ElectronicCats/badge_hackgdl_2026/Add-ons/Add-on-Pescadito-HackGDL/Footprints/CR2032--3DModel-STEP-56544.STEP

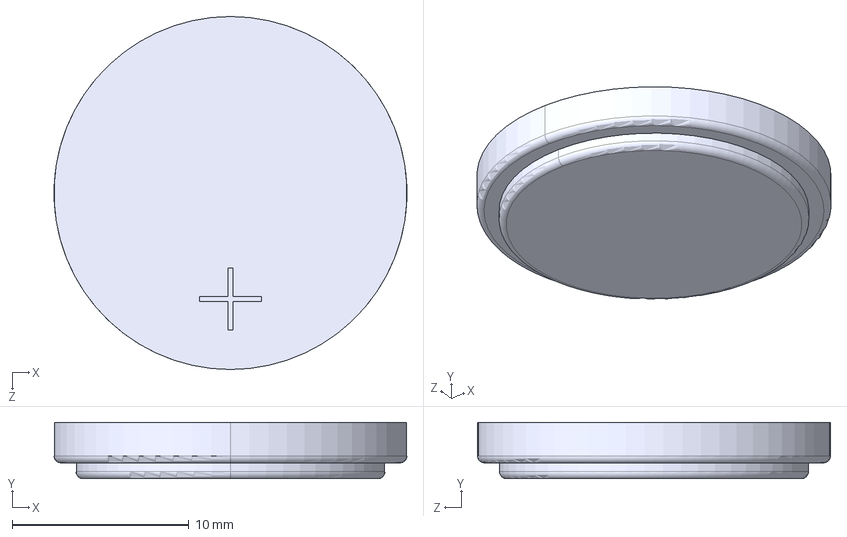
[picture p7: CAD file, 2026-01-30]
Add-ons/Add-on-Pescadito-HackGDL/Footprints/CR2032--3DModel-STEP-56544.STEP
20.0 x 3.20 x 20.0 mm
