ElectronicCats/badge_hackgdl_2026/Add-ons/Add-on-Tortuguita-HackGDL/Footprints/BAT-HLD-001--3DModel-STEP-56544.STEP

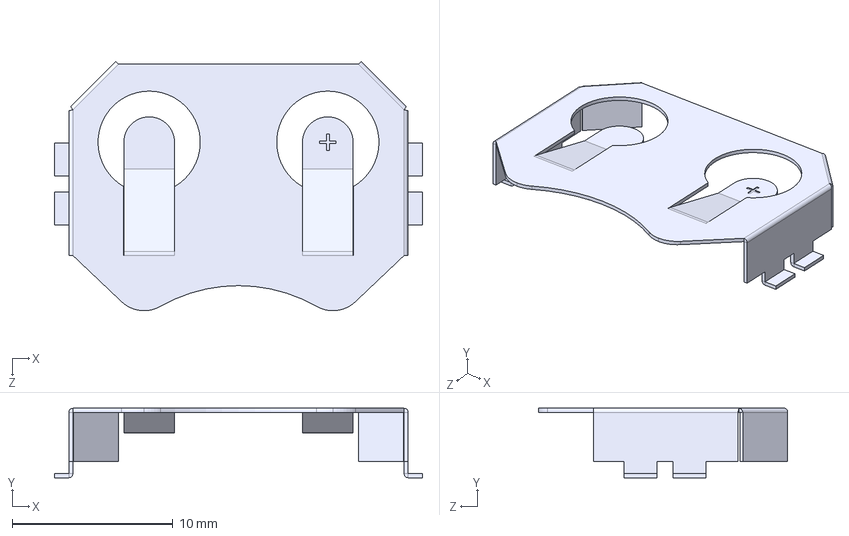
[picture p8: CAD file, 2026-01-30]
Add-ons/Add-on-Tortuguita-HackGDL/Footprints/BAT-HLD-001--3DModel-STEP-56544.STEP
22.9 x 4.32 x 15.5 mm
