ElectronicCats/badge_hackgdl_2026/hardware/Footprints/SON_WSON8_ZE_WIN.step

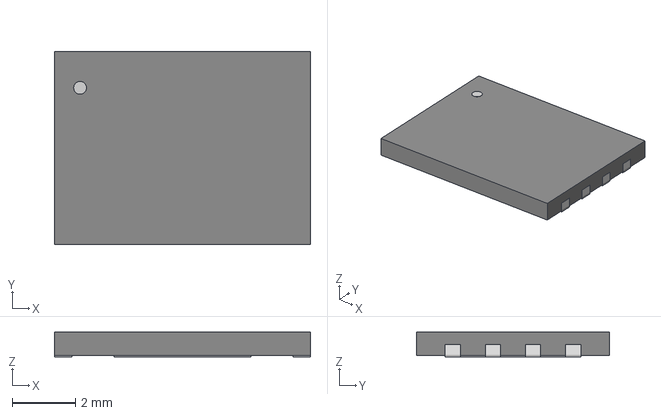
[picture p9: CAD file, 2026-01-27]
hardware/Footprints/SON_WSON8_ZE_WIN.step
8.10 x 6.10 x 0.79 mm
