ElectronicCats/badge_hackgdl_2026/hardware/Rear-Badge-HackGDL-2026/Rear-Badge-HackGDL-2026.step

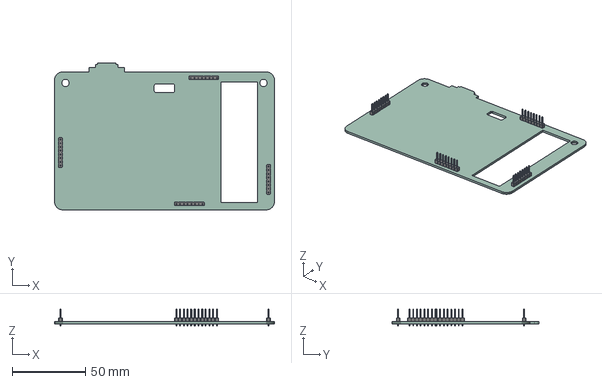
[picture p10: CAD file, 2026-01-27]
hardware/Rear-Badge-HackGDL-2026/Rear-Badge-HackGDL-2026.step
150.0 x 100.0 x 11.5 mm
PinHeader_1x08_P2.54mm_Vertical x 4
Rear-Badge-HackGDL-2026_PCB
