ElectronicCats/badge_hackgdl_2026/Add-ons/Add-on-Pescadito-HackGDL/Footprints/MSK12C02.stp

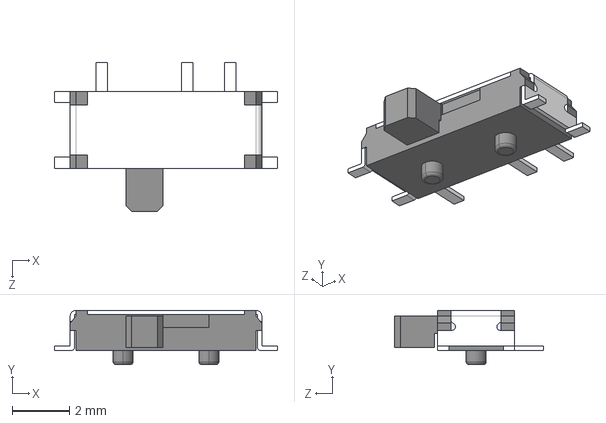
[picture p11: CAD file, 2026-01-30]
Add-ons/Add-on-Pescadito-HackGDL/Footprints/MSK12C02.stp
7.80 x 1.90 x 5.20 mm
