ElectronicCats/badge_hackgdl_2026/Add-ons/Add-on-Tortuguita-HackGDL/Add-on-Tortuguita-HackGDL.kicad_pcb

## KiCad design Add-ons/Add-on-Tortuguita-HackGDL/Add-on-Tortuguita-HackGDL.kicad_pcb (2026-01-30)

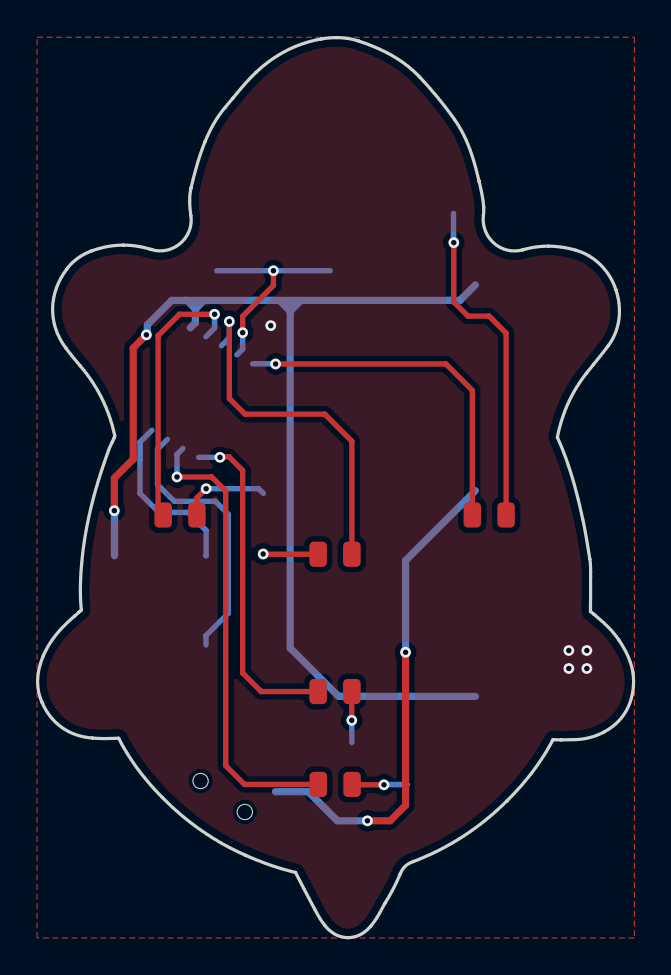
[picture p12: board Add-on-Tortuguita-HackGDL.kicad_pcb from above]

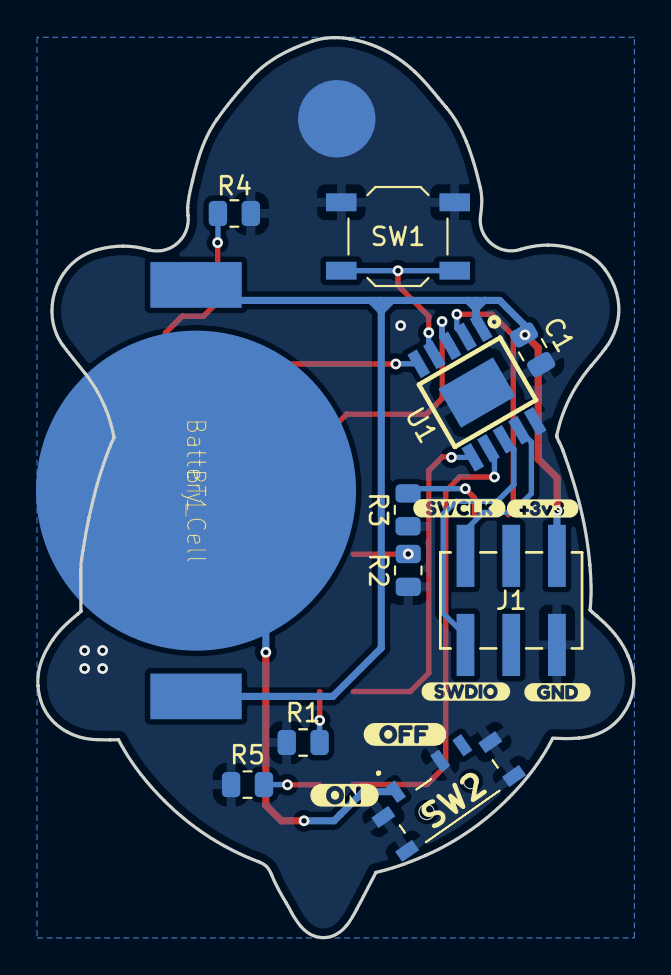
[picture p13: board Add-on-Tortuguita-HackGDL.kicad_pcb from below]

Board: 2 copper layers, 33.1 x 50.0 mm, 22 parts (17 on the bottom side), 16 nets.

Parts:
BT1: Battery_Cell; BAT-HLD-001
C1: 0.1uF; C_0805_2012Metric
D1, D2, D3, D4, D5: Red; LED_0805_2012Metric
J1: Conn_02x03_Odd_Even; B-2100N06P-B111_CKM
R1, R2, R3, R4, R5: 330R; R_0805_2012Metric
SW1: SW_RST; SW_SPST_TL3342
SW2: On; MSK12C02
U1: PY32F002AA15M6TU; PY32F002AA15M
kibuzzard-684B03BD: G***; kibuzzard-684B03BD
kibuzzard-684B03C9: G***; kibuzzard-684B03C9
kibuzzard-697CCF2B: G***; kibuzzard-697CCF2B
kibuzzard-6892952E: G***; kibuzzard-6892952E
kibuzzard-68929515: G***; kibuzzard-68929515
kibuzzard-68929520: G***; kibuzzard-68929520

Connections:
+3.3V: BT1.2 (+), C1.1, J1.6, U1.1 (VCC)
/NRST: SW1.2, U1.4 (PA0/PF2-NRST)
/PA1: D4.2 (A), U1.5 (PA1)
/PA5: D2.2 (A), U1.3 (PA5/PF1-OSCOUT)
/PA6: D1.2 (A), U1.6 (PA6)
/PA7: D5.2 (A), U1.7 (PA7)
/PF0: D3.2 (A), U1.2 (PF0-OSCIN)
/SWCLK: J1.2, U1.9 (PA14-SWC/PB3)
/SWDIO: J1.1, U1.8 (PA13-SWD)
GND: C1.2, J1.5, R1.1, R2.1, R3.1, R4.1, R5.1, SW1.1, SW2.2 (A), SW2.4 (C), U1.10 (GND)
unnamed: BT1.1 (-), SW2.1 (B)
unnamed: D1.1 (K), R1.2
unnamed: D2.1 (K), R2.2
unnamed: D3.1 (K), R3.2
unnamed: D4.1 (K), R4.2
unnamed: D5.1 (K), R5.2
