ElectronicCats/badge_hackgdl_2026/Add-ons/Add-on-Pescadito-HackGDL/Add-on-Pescadito-HackGDL.kicad_pcb

## KiCad design Add-ons/Add-on-Pescadito-HackGDL/Add-on-Pescadito-HackGDL.kicad_pcb (2026-01-30)

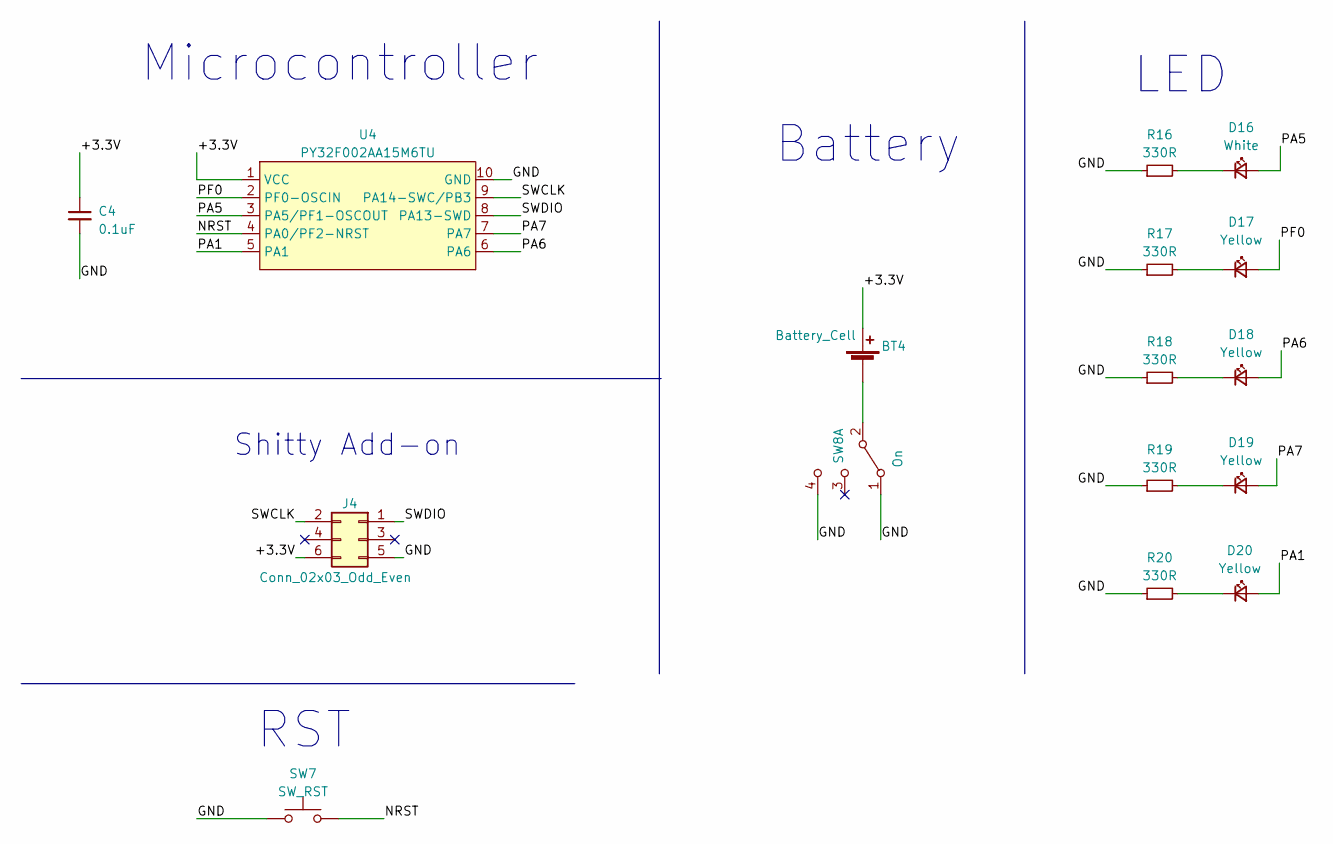
[picture p14: schematic Yellow_Fish.kicad_sch, Add-on_Pescaditos]

Parts:
BT4: Battery_Cell; BAT-HLD-001; LCSC# C964833
C4: 0.1uF; C_0805_2012Metric; LCSC# C235731
D16: White; LED_0805_2012Metric; LCSC# C84258
D17, D18, D19, D20: Yellow; LED_0805_2012Metric; LCSC# C84261
J4: Conn_02x03_Odd_Even; B-2100N06P-B111_CKM; LCSC# C124390
R16, R17, R18, R19, R20: 330R; R_0805_2012Metric; LCSC# C119075
SW7: SW_RST; SW_SPST_TL3342; LCSC# C318889
SW8: On; MSK12C02; LCSC# C431540
U4: PY32F002AA15M6TU; PY32F002AA15M; LCSC# C5292058

Connections:
/Yellow_Fish/+3.3V: BT4.2 (+), C4.1, J4.6, U4.1 (VCC)
/Yellow_Fish/GND: C4.2, J4.5, R16.1, R17.1, R18.1, R19.1, R20.1, SW7.1, SW8.1 (A), SW8.4 (C), U4.10 (GND)
/Yellow_Fish/NRST: SW7.2, U4.4 (PA0/PF2-NRST)
/Yellow_Fish/PA1: D20.2 (A), U4.5 (PA1)
/Yellow_Fish/PA5: D16.2 (A), U4.3 (PA5/PF1-OSCOUT)
/Yellow_Fish/PA6: D18.2 (A), U4.6 (PA6)
/Yellow_Fish/PA7: D19.2 (A), U4.7 (PA7)
/Yellow_Fish/PF0: D17.2 (A), U4.2 (PF0-OSCIN)
/Yellow_Fish/SWCLK: J4.2, U4.9 (PA14-SWC/PB3)
/Yellow_Fish/SWDIO: J4.1, U4.8 (PA13-SWD)
unnamed: BT4.1 (-), SW8.2 (B)
unnamed: D16.1 (K), R16.2
unnamed: D17.1 (K), R17.2
unnamed: D18.1 (K), R18.2
unnamed: D19.1 (K), R19.2
unnamed: D20.1 (K), R20.2

Notes on the sheet:
Battery
LED
Shitty Add-on
Microcontroller
RST

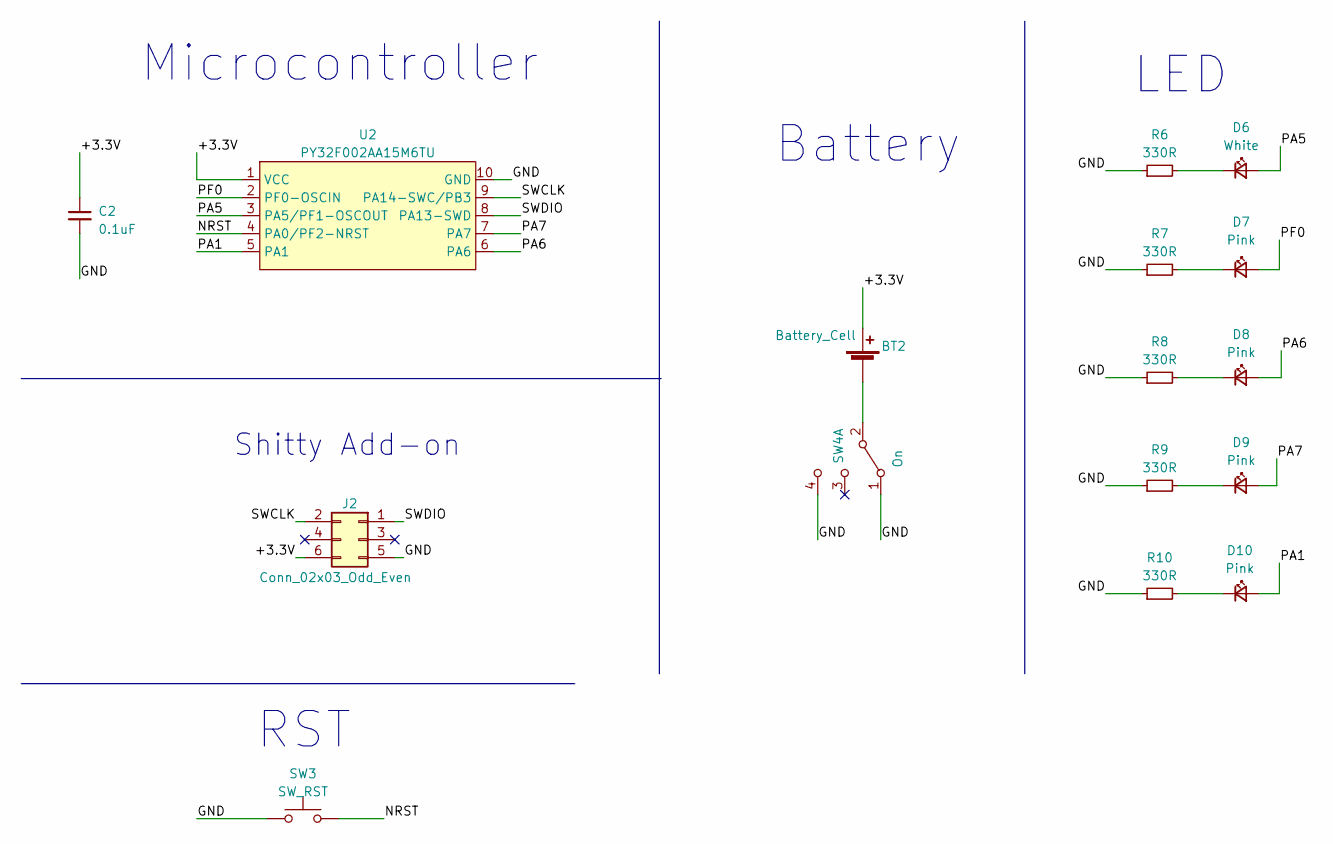
[picture p15: schematic Pink_Fish.kicad_sch, Add-on_Pescaditos]

Parts:
BT2: Battery_Cell; BAT-HLD-001; LCSC# C964833
C2: 0.1uF; C_0805_2012Metric; LCSC# C235731
D6: White; LED_0805_2012Metric; LCSC# C84258
D7, D8, D9, D10: Pink; LED_0805_2012Metric; LCSC# C965821
J2: Conn_02x03_Odd_Even; B-2100N06P-B111_CKM; LCSC# C124390
R6, R7, R8, R9, R10: 330R; R_0805_2012Metric; LCSC# C119075
SW3: SW_RST; SW_SPST_TL3342; LCSC# C318889
SW4: On; MSK12C02; LCSC# C431540
U2: PY32F002AA15M6TU; PY32F002AA15M; LCSC# C5292058

Connections:
/Pink_Fish/+3.3V: BT2.2 (+), C2.1, J2.6, U2.1 (VCC)
/Pink_Fish/GND: C2.2, J2.5, R6.1, R7.1, R8.1, R9.1, R10.1, SW3.1, SW4.1 (A), SW4.4 (C), U2.10 (GND)
/Pink_Fish/NRST: SW3.2, U2.4 (PA0/PF2-NRST)
/Pink_Fish/PA1: D10.2 (A), U2.5 (PA1)
/Pink_Fish/PA5: D6.2 (A), U2.3 (PA5/PF1-OSCOUT)
/Pink_Fish/PA6: D8.2 (A), U2.6 (PA6)
/Pink_Fish/PA7: D9.2 (A), U2.7 (PA7)
/Pink_Fish/PF0: D7.2 (A), U2.2 (PF0-OSCIN)
/Pink_Fish/SWCLK: J2.2, U2.9 (PA14-SWC/PB3)
/Pink_Fish/SWDIO: J2.1, U2.8 (PA13-SWD)
unnamed: BT2.1 (-), SW4.2 (B)
unnamed: D6.1 (K), R6.2
unnamed: D7.1 (K), R7.2
unnamed: D8.1 (K), R8.2
unnamed: D9.1 (K), R9.2
unnamed: D10.1 (K), R10.2

Notes on the sheet:
Microcontroller
LED
RST
Shitty Add-on
Battery

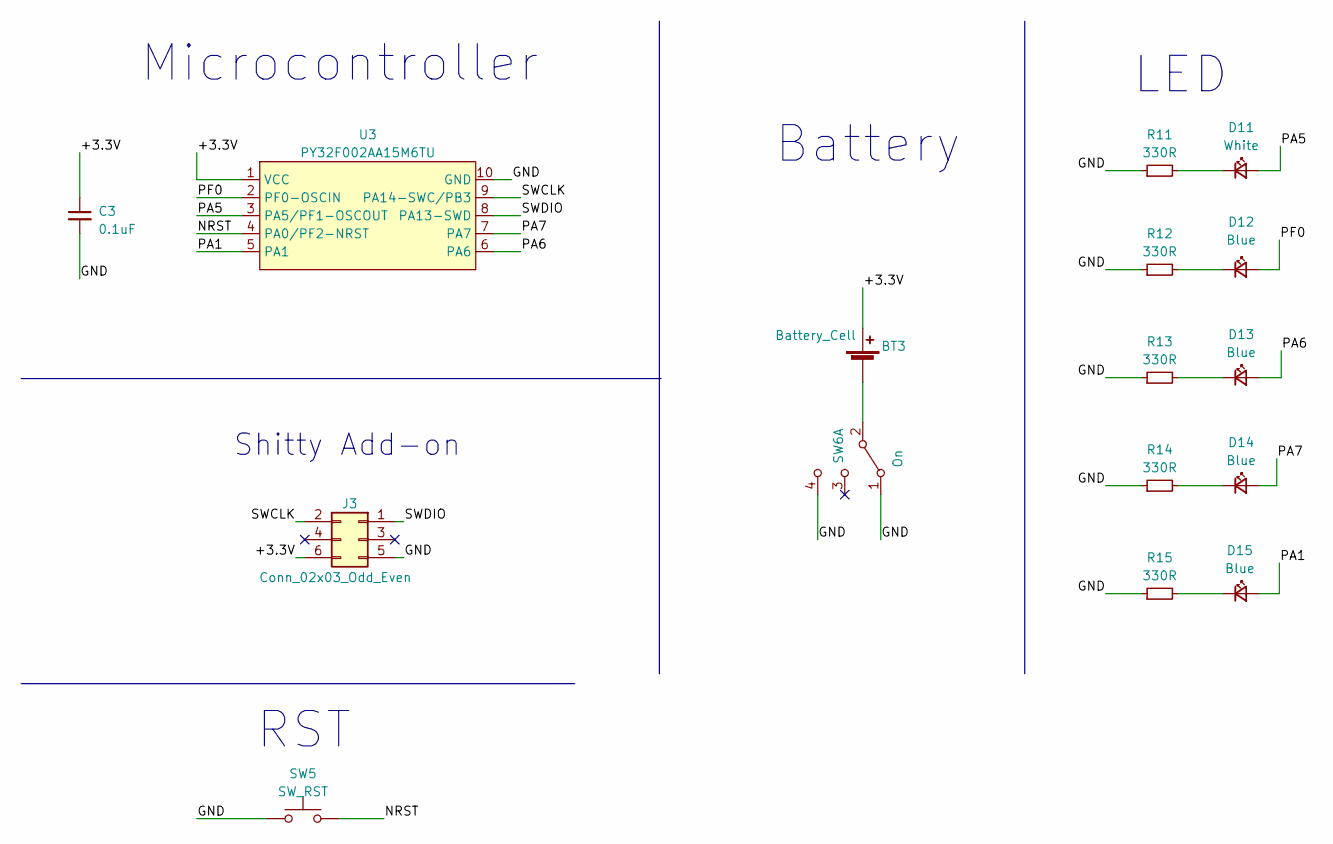
[picture p16: schematic Blue_Fish.kicad_sch, Add-on_Pescaditos]

Parts:
BT3: Battery_Cell; BAT-HLD-001; LCSC# C964833
C3: 0.1uF; C_0805_2012Metric; LCSC# C235731
D11: White; LED_0805_2012Metric; LCSC# C84258
D12, D13, D14, D15: Blue; LED_0805_2012Metric; LCSC# C205441
J3: Conn_02x03_Odd_Even; B-2100N06P-B111_CKM; LCSC# C124390
R11, R12, R13, R14, R15: 330R; R_0805_2012Metric; LCSC# C119075
SW5: SW_RST; SW_SPST_TL3342; LCSC# C318889
SW6: On; MSK12C02; LCSC# C431540
U3: PY32F002AA15M6TU; PY32F002AA15M; LCSC# C5292058

Connections:
/Blue_Fish/+3.3V: BT3.2 (+), C3.1, J3.6, U3.1 (VCC)
/Blue_Fish/GND: C3.2, J3.5, R11.1, R12.1, R13.1, R14.1, R15.1, SW5.1, SW6.1 (A), SW6.4 (C), U3.10 (GND)
/Blue_Fish/NRST: SW5.2, U3.4 (PA0/PF2-NRST)
/Blue_Fish/PA1: D15.2 (A), U3.5 (PA1)
/Blue_Fish/PA5: D11.2 (A), U3.3 (PA5/PF1-OSCOUT)
/Blue_Fish/PA6: D13.2 (A), U3.6 (PA6)
/Blue_Fish/PA7: D14.2 (A), U3.7 (PA7)
/Blue_Fish/PF0: D12.2 (A), U3.2 (PF0-OSCIN)
/Blue_Fish/SWCLK: J3.2, U3.9 (PA14-SWC/PB3)
/Blue_Fish/SWDIO: J3.1, U3.8 (PA13-SWD)
unnamed: BT3.1 (-), SW6.2 (B)
unnamed: D11.1 (K), R11.2
unnamed: D12.1 (K), R12.2
unnamed: D13.1 (K), R13.2
unnamed: D14.1 (K), R14.2
unnamed: D15.1 (K), R15.2

Notes on the sheet:
Shitty Add-on
Battery
RST
LED
Microcontroller

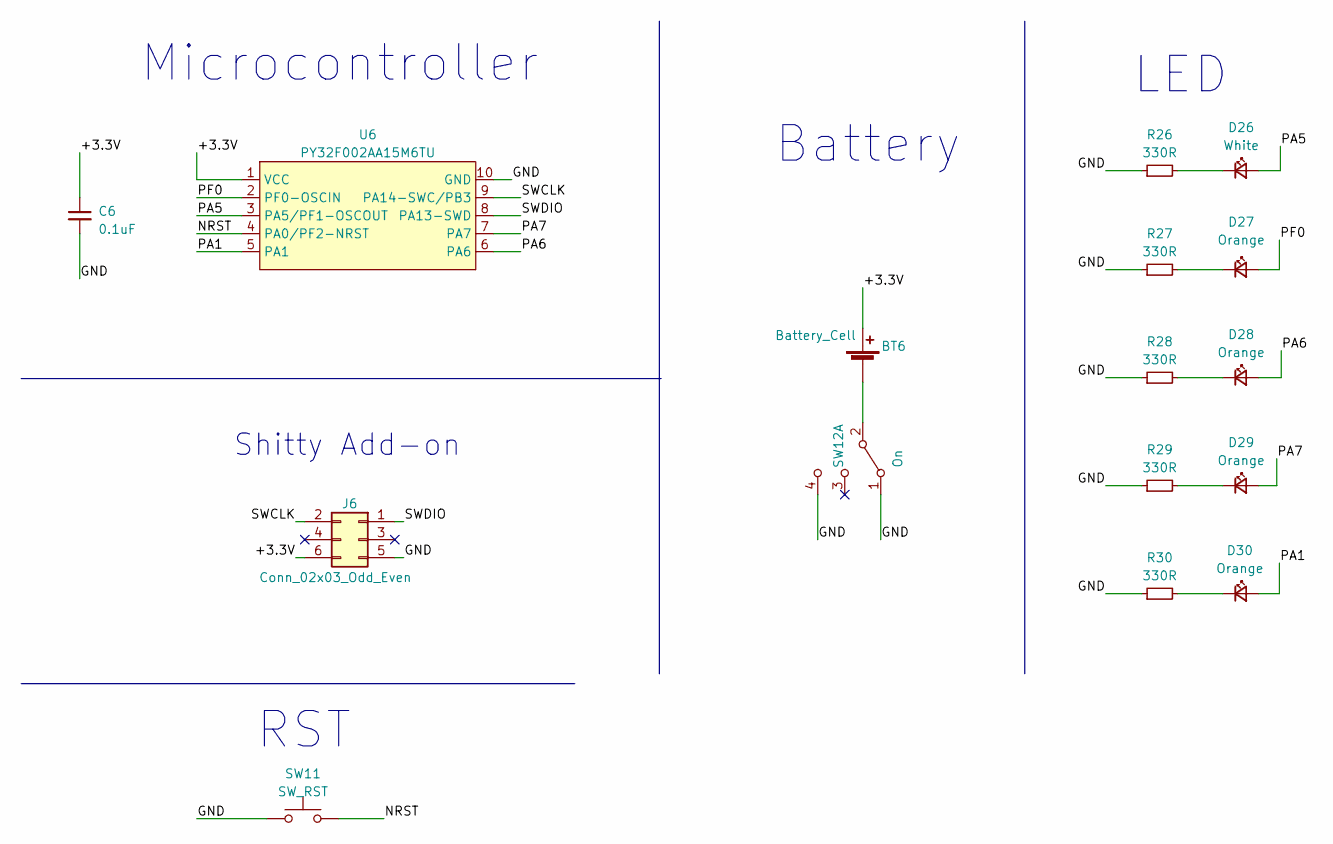
[picture p17: schematic Orange_Fish.kicad_sch, Add-on_Pescaditos]

Parts:
BT6: Battery_Cell; BAT-HLD-001; LCSC# C964833
C6: 0.1uF; C_0805_2012Metric; LCSC# C235731
D26: White; LED_0805_2012Metric; LCSC# C84258
D27, D28, D29, D30: Orange; LED_0805_2012Metric; LCSC# C434437
J6: Conn_02x03_Odd_Even; B-2100N06P-B111_CKM; LCSC# C124390
R26, R27, R28, R29, R30: 330R; R_0805_2012Metric; LCSC# C119075
SW11: SW_RST; SW_SPST_TL3342; LCSC# C318889
SW12: On; MSK12C02; LCSC# C431540
U6: PY32F002AA15M6TU; PY32F002AA15M; LCSC# C5292058

Connections:
/Orange_Fish/+3.3V: BT6.2 (+), C6.1, J6.6, U6.1 (VCC)
/Orange_Fish/GND: C6.2, J6.5, R26.1, R27.1, R28.1, R29.1, R30.1, SW11.1, SW12.1 (A), SW12.4 (C), U6.10 (GND)
/Orange_Fish/NRST: SW11.2, U6.4 (PA0/PF2-NRST)
/Orange_Fish/PA1: D30.2 (A), U6.5 (PA1)
/Orange_Fish/PA5: D26.2 (A), U6.3 (PA5/PF1-OSCOUT)
/Orange_Fish/PA6: D28.2 (A), U6.6 (PA6)
/Orange_Fish/PA7: D29.2 (A), U6.7 (PA7)
/Orange_Fish/PF0: D27.2 (A), U6.2 (PF0-OSCIN)
/Orange_Fish/SWCLK: J6.2, U6.9 (PA14-SWC/PB3)
/Orange_Fish/SWDIO: J6.1, U6.8 (PA13-SWD)
unnamed: BT6.1 (-), SW12.2 (B)
unnamed: D26.1 (K), R26.2
unnamed: D27.1 (K), R27.2
unnamed: D28.1 (K), R28.2
unnamed: D29.1 (K), R29.2
unnamed: D30.1 (K), R30.2

Notes on the sheet:
LED
Shitty Add-on
Battery
Microcontroller
RST

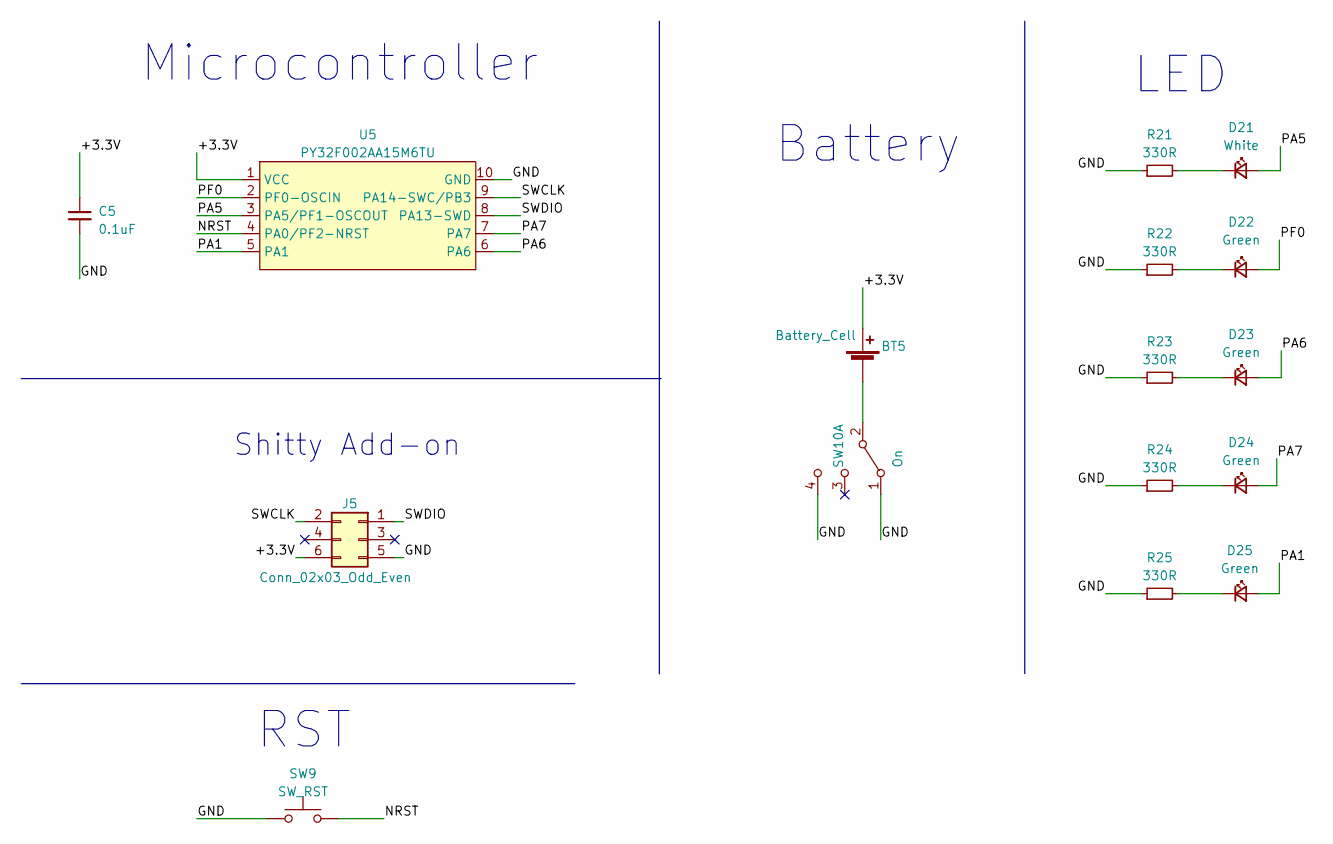
[picture p18: schematic Green_Fish.kicad_sch, Add-on_Pescaditos]

Parts:
BT5: Battery_Cell; BAT-HLD-001; LCSC# C964833
C5: 0.1uF; C_0805_2012Metric; LCSC# C235731
D21: White; LED_0805_2012Metric; LCSC# C84258
D22, D23, D24, D25: Green; LED_0805_2012Metric; LCSC# C965815
J5: Conn_02x03_Odd_Even; B-2100N06P-B111_CKM; LCSC# C124390
R21, R22, R23, R24, R25: 330R; R_0805_2012Metric; LCSC# C119075
SW9: SW_RST; SW_SPST_TL3342; LCSC# C318889
SW10: On; MSK12C02; LCSC# C431540
U5: PY32F002AA15M6TU; PY32F002AA15M; LCSC# C5292058

Connections:
/Green_Fish/+3.3V: BT5.2 (+), C5.1, J5.6, U5.1 (VCC)
/Green_Fish/GND: C5.2, J5.5, R21.1, R22.1, R23.1, R24.1, R25.1, SW9.1, SW10.1 (A), SW10.4 (C), U5.10 (GND)
/Green_Fish/NRST: SW9.2, U5.4 (PA0/PF2-NRST)
/Green_Fish/PA1: D25.2 (A), U5.5 (PA1)
/Green_Fish/PA5: D21.2 (A), U5.3 (PA5/PF1-OSCOUT)
/Green_Fish/PA6: D23.2 (A), U5.6 (PA6)
/Green_Fish/PA7: D24.2 (A), U5.7 (PA7)
/Green_Fish/PF0: D22.2 (A), U5.2 (PF0-OSCIN)
/Green_Fish/SWCLK: J5.2, U5.9 (PA14-SWC/PB3)
/Green_Fish/SWDIO: J5.1, U5.8 (PA13-SWD)
unnamed: BT5.1 (-), SW10.2 (B)
unnamed: D21.1 (K), R21.2
unnamed: D22.1 (K), R22.2
unnamed: D23.1 (K), R23.2
unnamed: D24.1 (K), R24.2
unnamed: D25.1 (K), R25.2

Notes on the sheet:
Battery
RST
Shitty Add-on
Microcontroller
LED

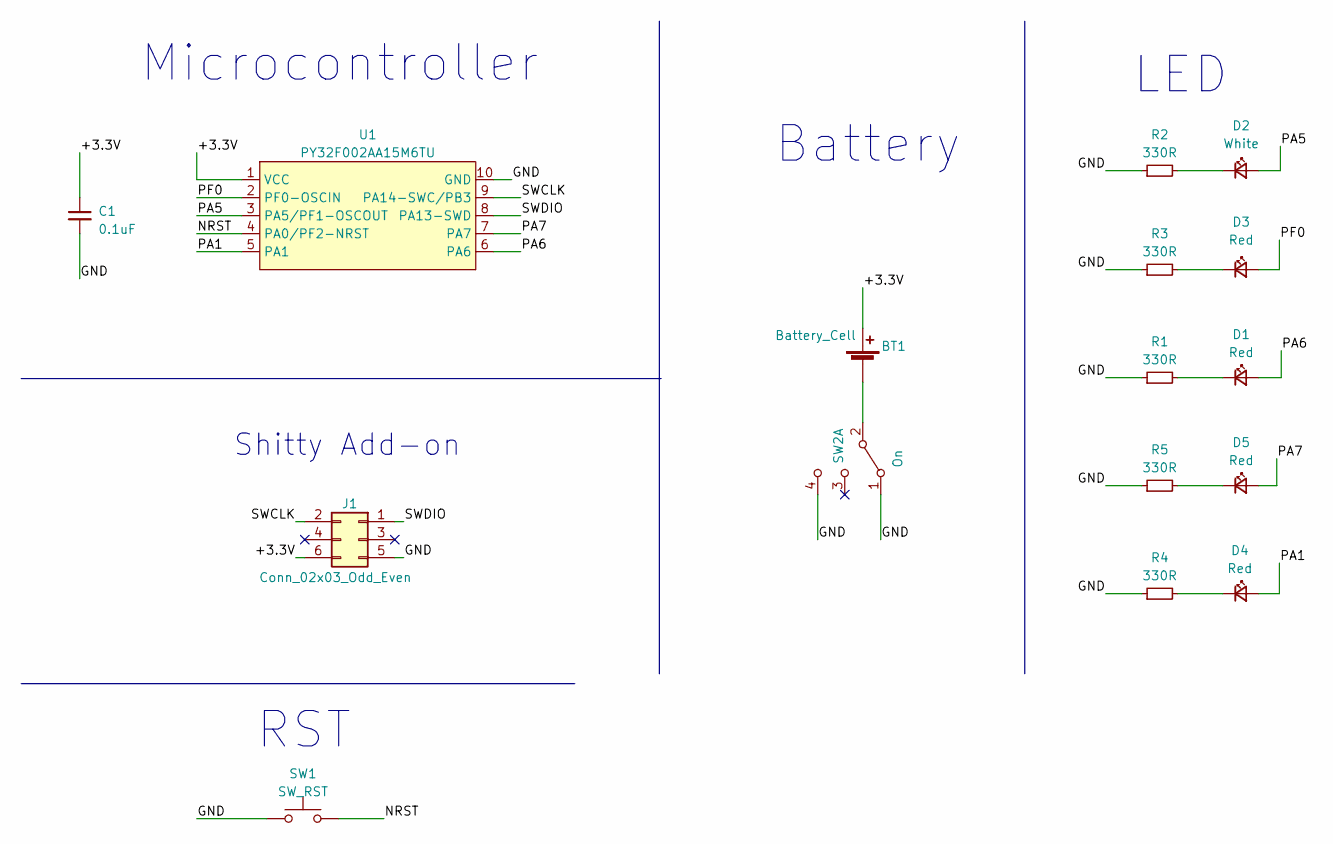
[picture p19: schematic Red_Fish.kicad_sch, Add-on_Pescaditos]

Parts:
BT1: Battery_Cell; BAT-HLD-001; LCSC# C964833
C1: 0.1uF; C_0805_2012Metric; LCSC# C235731
D1, D3, D4, D5: Red; LED_0805_2012Metric; LCSC# C965812
D2: White; LED_0805_2012Metric; LCSC# C84258
J1: Conn_02x03_Odd_Even; B-2100N06P-B111_CKM; LCSC# C124390
R1, R2, R3, R4, R5: 330R; R_0805_2012Metric; LCSC# C119075
SW1: SW_RST; SW_SPST_TL3342; LCSC# C318889
SW2: On; MSK12C02; LCSC# C431540
U1: PY32F002AA15M6TU; PY32F002AA15M; LCSC# C5292058

Connections:
/Red_Fish/+3.3V: BT1.2 (+), C1.1, J1.6, U1.1 (VCC)
/Red_Fish/GND: C1.2, J1.5, R1.1, R2.1, R3.1, R4.1, R5.1, SW1.1, SW2.1 (A), SW2.4 (C), U1.10 (GND)
/Red_Fish/NRST: SW1.2, U1.4 (PA0/PF2-NRST)
/Red_Fish/PA1: D4.2 (A), U1.5 (PA1)
/Red_Fish/PA5: D2.2 (A), U1.3 (PA5/PF1-OSCOUT)
/Red_Fish/PA6: D1.2 (A), U1.6 (PA6)
/Red_Fish/PA7: D5.2 (A), U1.7 (PA7)
/Red_Fish/PF0: D3.2 (A), U1.2 (PF0-OSCIN)
/Red_Fish/SWCLK: J1.2, U1.9 (PA14-SWC/PB3)
/Red_Fish/SWDIO: J1.1, U1.8 (PA13-SWD)
unnamed: BT1.1 (-), SW2.2 (B)
unnamed: D1.1 (K), R1.2
unnamed: D2.1 (K), R2.2
unnamed: D3.1 (K), R3.2
unnamed: D4.1 (K), R4.2
unnamed: D5.1 (K), R5.2

Notes on the sheet:
LED
Battery
Microcontroller
RST
Shitty Add-on

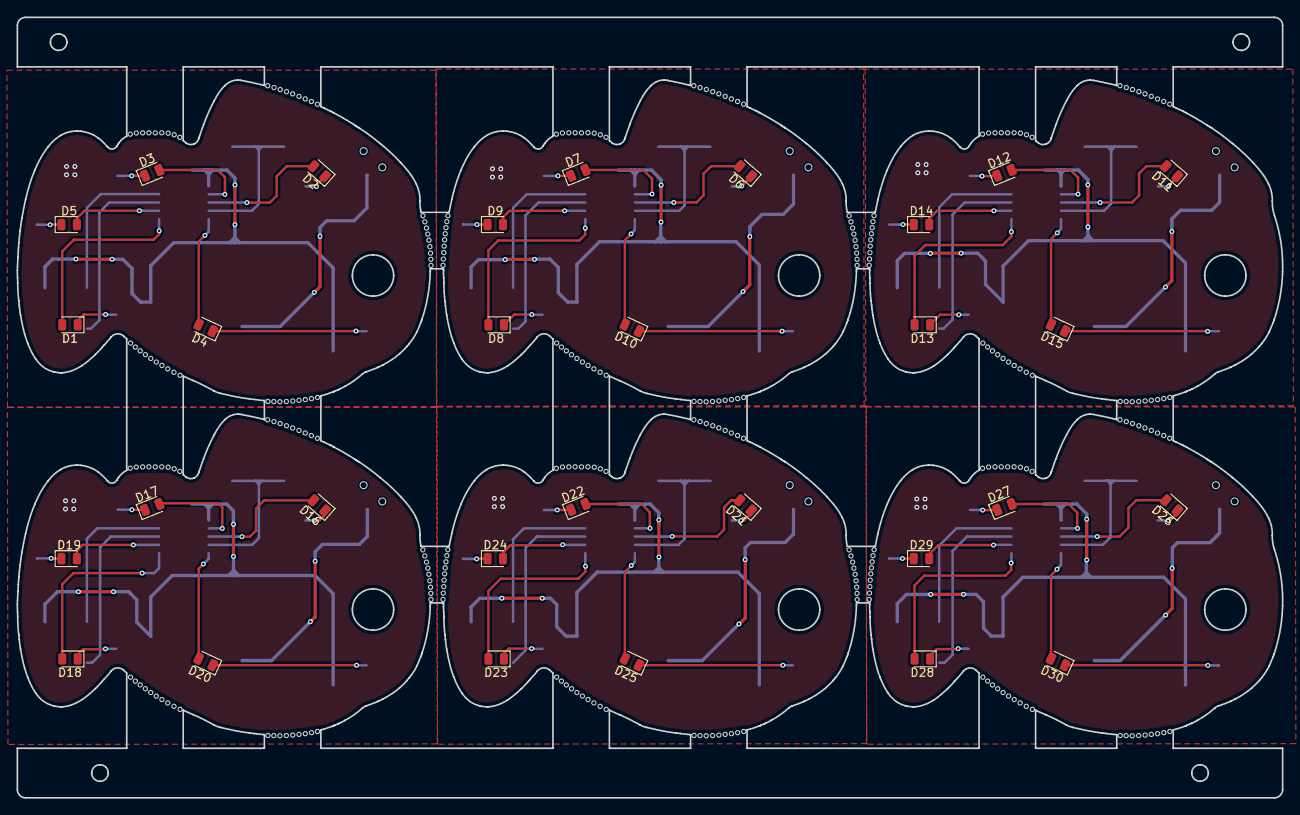
[picture p20: board Add-on-Pescadito-HackGDL.kicad_pcb from above]

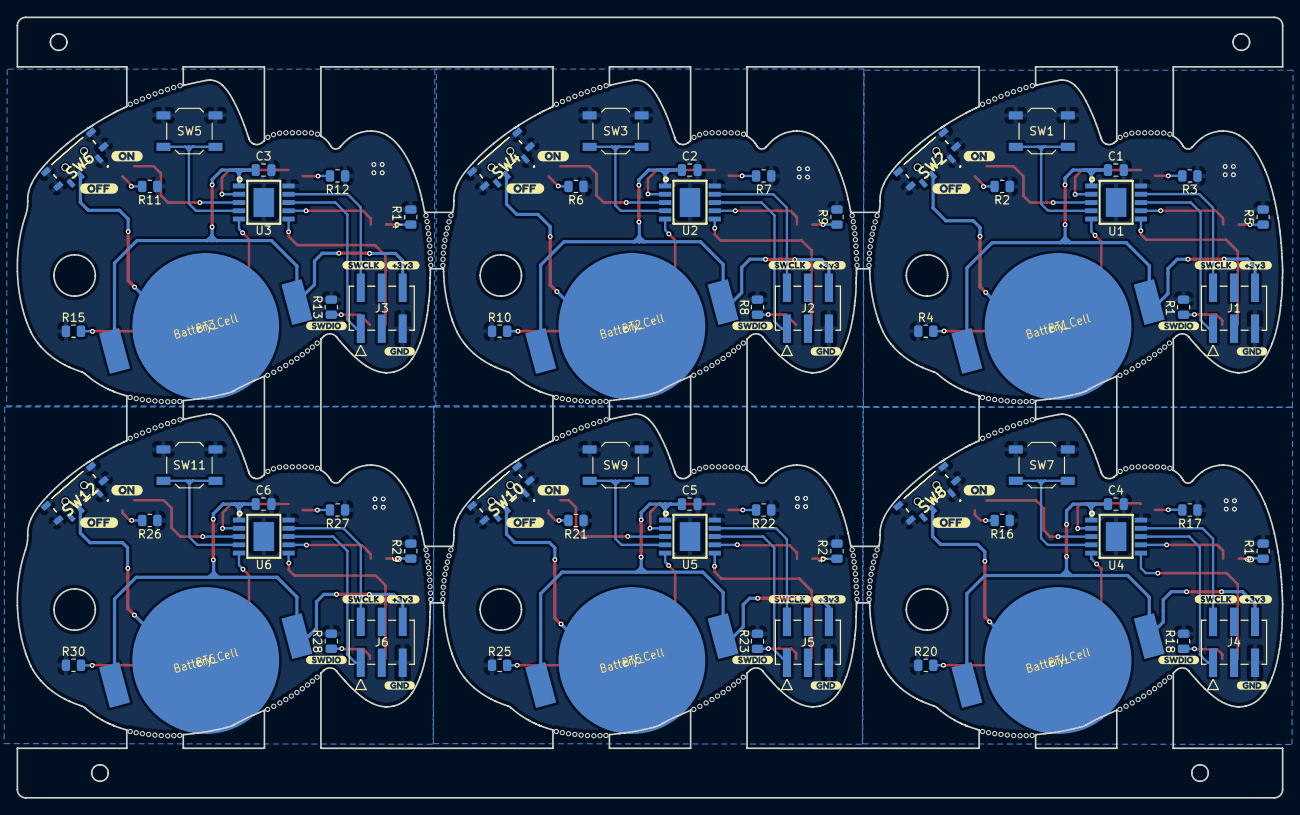
[picture p21: board Add-on-Pescadito-HackGDL.kicad_pcb from below]

Board: 2 copper layers, 153.2 x 94.5 mm, 132 parts (102 on the bottom side), 96 nets.

Other parts of the board:
kibuzzard-684B03BD, kibuzzard-684B03BD#2, kibuzzard-684B03BD#3, kibuzzard-684B03BD#4, kibuzzard-684B03BD#5, kibuzzard-684B03BD#6: G***; kibuzzard-684B03BD
kibuzzard-684B03C9, kibuzzard-684B03C9#2, kibuzzard-684B03C9#3, kibuzzard-684B03C9#4, kibuzzard-684B03C9#5, kibuzzard-684B03C9#6: G***; kibuzzard-684B03C9
kibuzzard-697CCF2B, kibuzzard-697CCF2B#2, kibuzzard-697CCF2B#3, kibuzzard-697CCF2B#4, kibuzzard-697CCF2B#5, kibuzzard-697CCF2B#6: G***; kibuzzard-697CCF2B
kibuzzard-6892952E, kibuzzard-6892952E#2, kibuzzard-6892952E#3, kibuzzard-6892952E#4, kibuzzard-6892952E#5, kibuzzard-6892952E#6: G***; kibuzzard-6892952E
kibuzzard-68929515, kibuzzard-68929515#2, kibuzzard-68929515#3, kibuzzard-68929515#4, kibuzzard-68929515#5, kibuzzard-68929515#6: G***; kibuzzard-68929515
kibuzzard-68929520, kibuzzard-68929520#2, kibuzzard-68929520#3, kibuzzard-68929520#4, kibuzzard-68929520#5, kibuzzard-68929520#6: G***; kibuzzard-68929520
