ElectronicCats/badge_hackgdl_2026/hardware/Badge-HackGDL-2026.kicad_pcb

## KiCad design hardware/Badge-HackGDL-2026.kicad_pcb (2026-01-27)

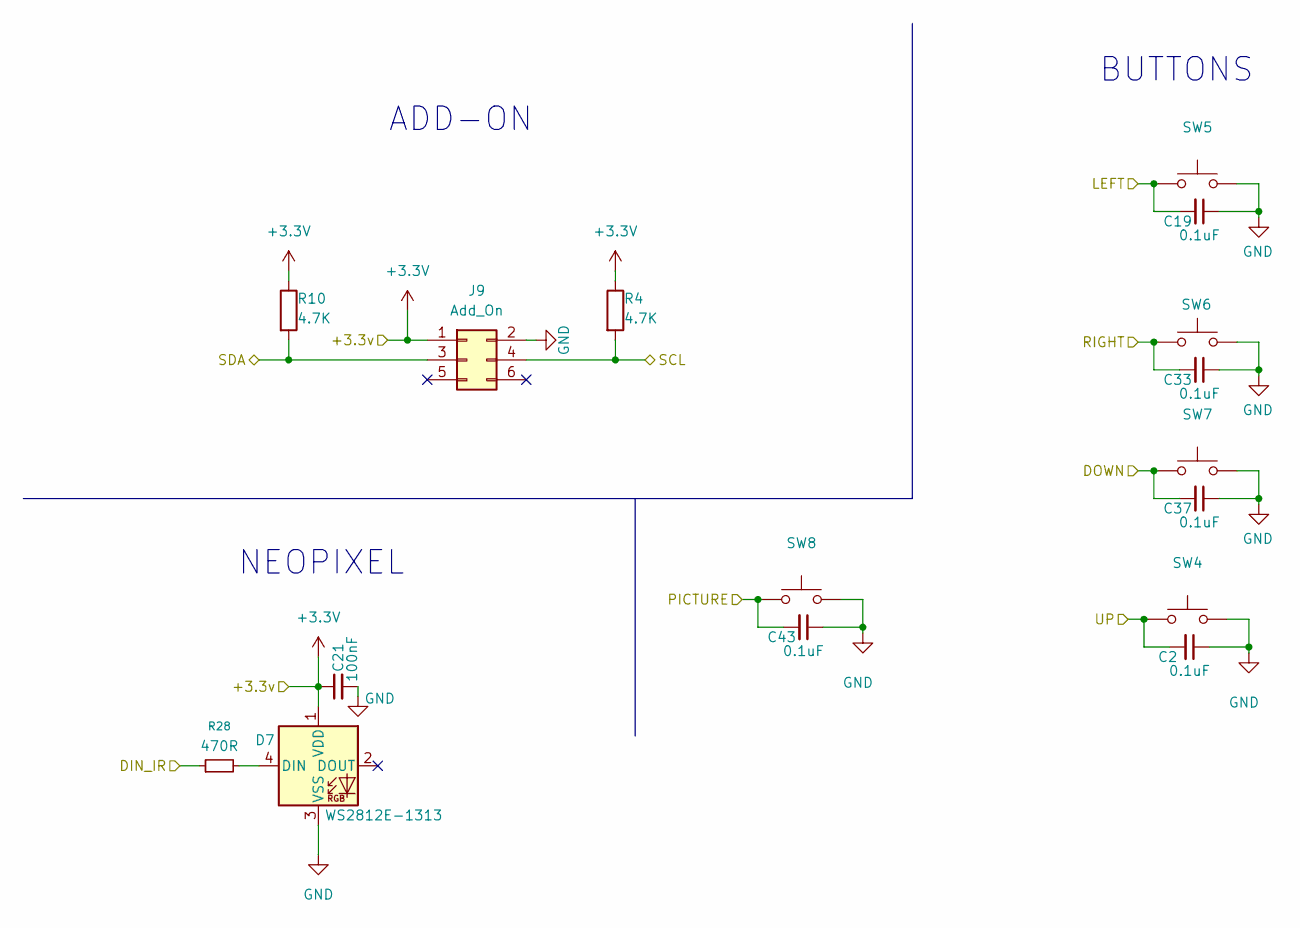
[picture p22: schematic Otros.kicad_sch, Badge-HackGDL-2026]

Parts:
C2, C19, C33, C37, C43: 0.1uF; C_0603_1608Metric; LCSC# C478888
C21: 100nF; C_0402_1005Metric; LCSC# C77020
D7: WS2812E-1313; LCSC# C5446700
J9: Add_On; PinSocket_2x03_P2.54mm_Vertical; LCSC# C5116527
R4, R10: 4.7K; C_0603_1608Metric; LCSC# C2907166
R28: 470R; R_0603_1608Metric; LCSC# C23179
SW4, SW5, SW6, SW7: SW_SPST_TL3342; LCSC# C318889
SW8: Button_6.6x6.5; LCSC# C480263

Connections:
+3.3V: C21.1, D7.1 (VDD), J9.1, R4.1, R10.1; also elsewhere on the board
/MCU/DIN_IR: R28.1; also elsewhere on the board
/MCU/DOWN: C37.2, SW7.2; also elsewhere on the board
/MCU/LEFT: C19.2, SW5.2; also elsewhere on the board
/MCU/PICTURE: C43.2, SW8.2; also elsewhere on the board
/MCU/RIGHT: C33.2, SW6.2; also elsewhere on the board
/MCU/SCL: J9.4, R4.2; also elsewhere on the board
/MCU/SDA: J9.3, R10.2; also elsewhere on the board
/MCU/UP: C2.2, SW4.2; also elsewhere on the board
GND: C2.1, C19.1, C21.2, C33.1, C37.1, C43.1, D7.3 (VSS), J9.2, SW4.1, SW5.1, SW6.1, SW7.1, SW8.1; also elsewhere on the board
unnamed: D7.4 (DIN), R28.2

Notes on the sheet:
BUTTONS
ADD-ON
NEOPIXEL

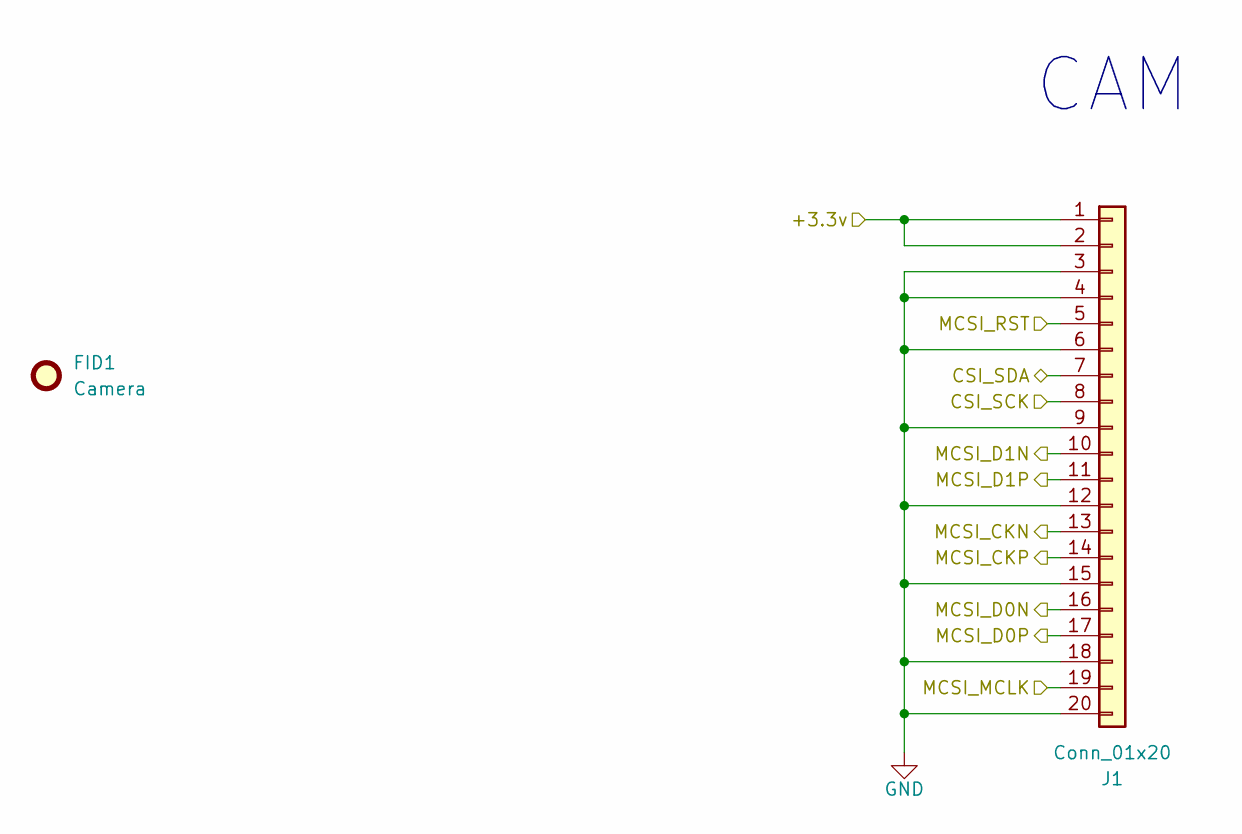
[picture p23: schematic Cam.kicad_sch, Badge-HackGDL-2026]

Parts:
FID1: Camera; Untitled
J1: Conn_01x20; Hirose_FH12-20S-0.5SH_1x20-1MP_P0.50mm_Horizontal; LCSC# C2906119

Connections:
+3.3V: J1.1, J1.2; also elsewhere on the board
/Cam/CSI_SCK: J1.8; also elsewhere on the board
/Cam/CSI_SDA: J1.7; also elsewhere on the board
/Cam/MCSI_CKN: J1.13; also elsewhere on the board
/Cam/MCSI_CKP: J1.14; also elsewhere on the board
/Cam/MCSI_D0N: J1.16; also elsewhere on the board
/Cam/MCSI_D0P: J1.17; also elsewhere on the board
/Cam/MCSI_D1N: J1.10; also elsewhere on the board
/Cam/MCSI_D1P: J1.11; also elsewhere on the board
/Cam/MCSI_MCLK: J1.19; also elsewhere on the board
/Cam/MCSI_RST: J1.5; also elsewhere on the board
GND: J1.3, J1.4, J1.6, J1.9, J1.12, J1.15, J1.18, J1.20; also elsewhere on the board

Notes on the sheet:
CAM
