ElectronicCats/badge_hackgdl_2026/hardware/Badge-HackGDL-2026.kicad_pcb

## KiCad design hardware/Badge-HackGDL-2026.kicad_pcb (continued)

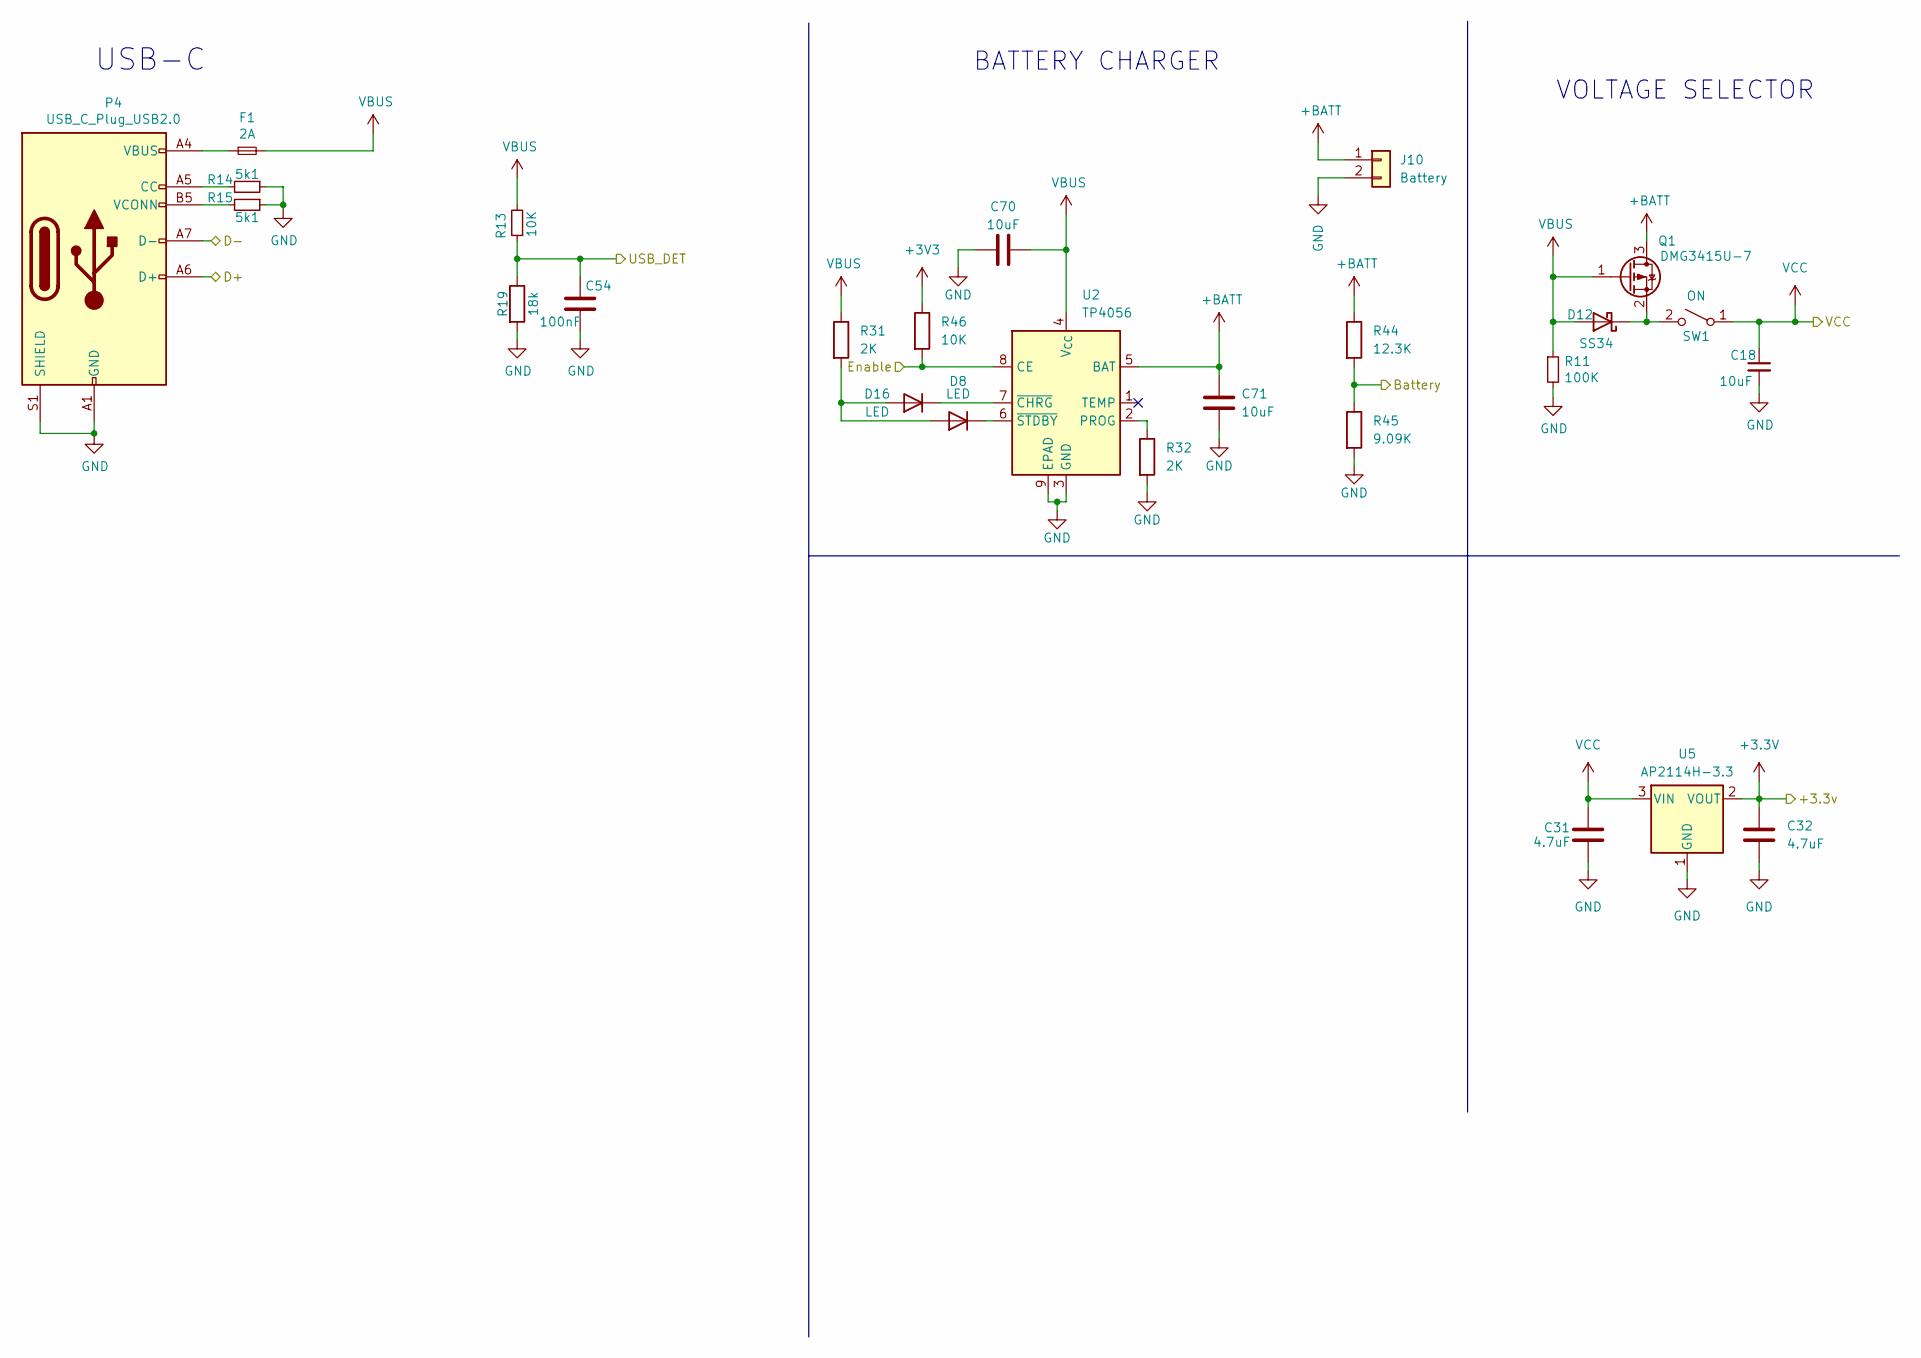
[picture p24: schematic USB.kicad_sch, Badge-HackGDL-2026]

Parts:
C18: 10uF; C_0402_1005Metric; LCSC# C7472949
C31, C32: 4.7uF; C_0402_1005Metric; LCSC# C368809
C54: 100nF; C_0402_1005Metric; LCSC# C77020
C70, C71: 10uF; C_0603_1608Metric; LCSC# C96446
D8, D16: LED; LED_0603_1608Metric; LCSC# C22371297
D12: SS34; D_SMA; LCSC# C908680
F1: 2A; Fuse_0603_1608Metric; LCSC# C41380229
J10: Battery; BatteryHolder_Keystone_1042_1x18650; LCSC# C2988620
P4: USB_C_Plug_USB2.0; C393939; LCSC# C2760486
Q1: DMG3415U-7; SOT-23; LCSC# C96616
R11: 100K; R_0603_1608Metric; LCSC# C15458
R13, R46: 10K; R_0402_1005Metric; LCSC# C2759535
R14, R15: 5k1; R_0603_1608Metric; LCSC# C2907044
R19: 18k; R_0402_1005Metric; LCSC# C323741
R31, R32: 2K; R_0603_1608Metric; LCSC# C2907022
R44: 12.3K; R_0402_1005Metric; LCSC# C346621
R45: 9.09K; R_0402_1005Metric; LCSC# C852966
SW1: ON; SW_Slide_SPDT_Angled_CK_OS102011MA1Q; LCSC# C393937
U2: TP4056; SOIC-8-1EP_3.9x4.9mm_P1.27mm_EP2.41x3.3mm_ThermalVias; LCSC# C725790
U5: AP2114H-3.3; SOT-223-3_TabPin2; LCSC# C150716

Connections:
+3.3V: C32.1, U5.2 (VOUT); also elsewhere on the board
+3V3: R46.1; also elsewhere on the board
+BATT: C71.1, J10.1, Q1.3 (D), R44.1, U2.5 (BAT)
/MCU/Battery: R44.2, R45.1; also elsewhere on the board
/MCU/D+: P4.A6 (D+); also elsewhere on the board
/MCU/D-: P4.A7 (D-); also elsewhere on the board
/MCU/Enable: R46.2, U2.8 (CE); also elsewhere on the board
/MCU/USB_DET: C54.1, R13.1, R19.1; also elsewhere on the board
GND: C18.2, C31.2, C32.2, C54.2, C70.1, C71.2, J10.2, P4.A1 (GND), P4.A12 (GND), P4.B1 (GND), P4.B12 (GND), P4.S1 (SHIELD), R11.2, R14.1, R15.1, R19.2, R32.2, R45.2, U2.3 (GND), U2.9 (EPAD), U5.1 (GND); also elsewhere on the board
unnamed: D8.1 (K), U2.6 (~STDBY)
unnamed: D12.1 (K), Q1.2 (S), SW1.2 (B)
unnamed: D8.2 (A), D16.2 (A), R31.2
unnamed: D16.1 (K), U2.7 (~CHRG)
unnamed: F1.1, P4.A4 (VBUS), P4.A9 (VBUS), P4.B4 (VBUS), P4.B9 (VBUS)
unnamed: P4.A5 (CC), R14.2
unnamed: P4.B5 (VCONN), R15.2
unnamed: R32.1, U2.2 (PROG)
VBUS: C70.2, D12.2 (A), F1.2, Q1.1 (G), R11.1, R13.2, R31.1, U2.4 (V_{CC})
VCC: C18.1, C31.1, SW1.1 (A), U5.3 (VIN); also elsewhere on the board

Notes on the sheet:
VOLTAGE SELECTOR
USB-C
BATTERY CHARGER

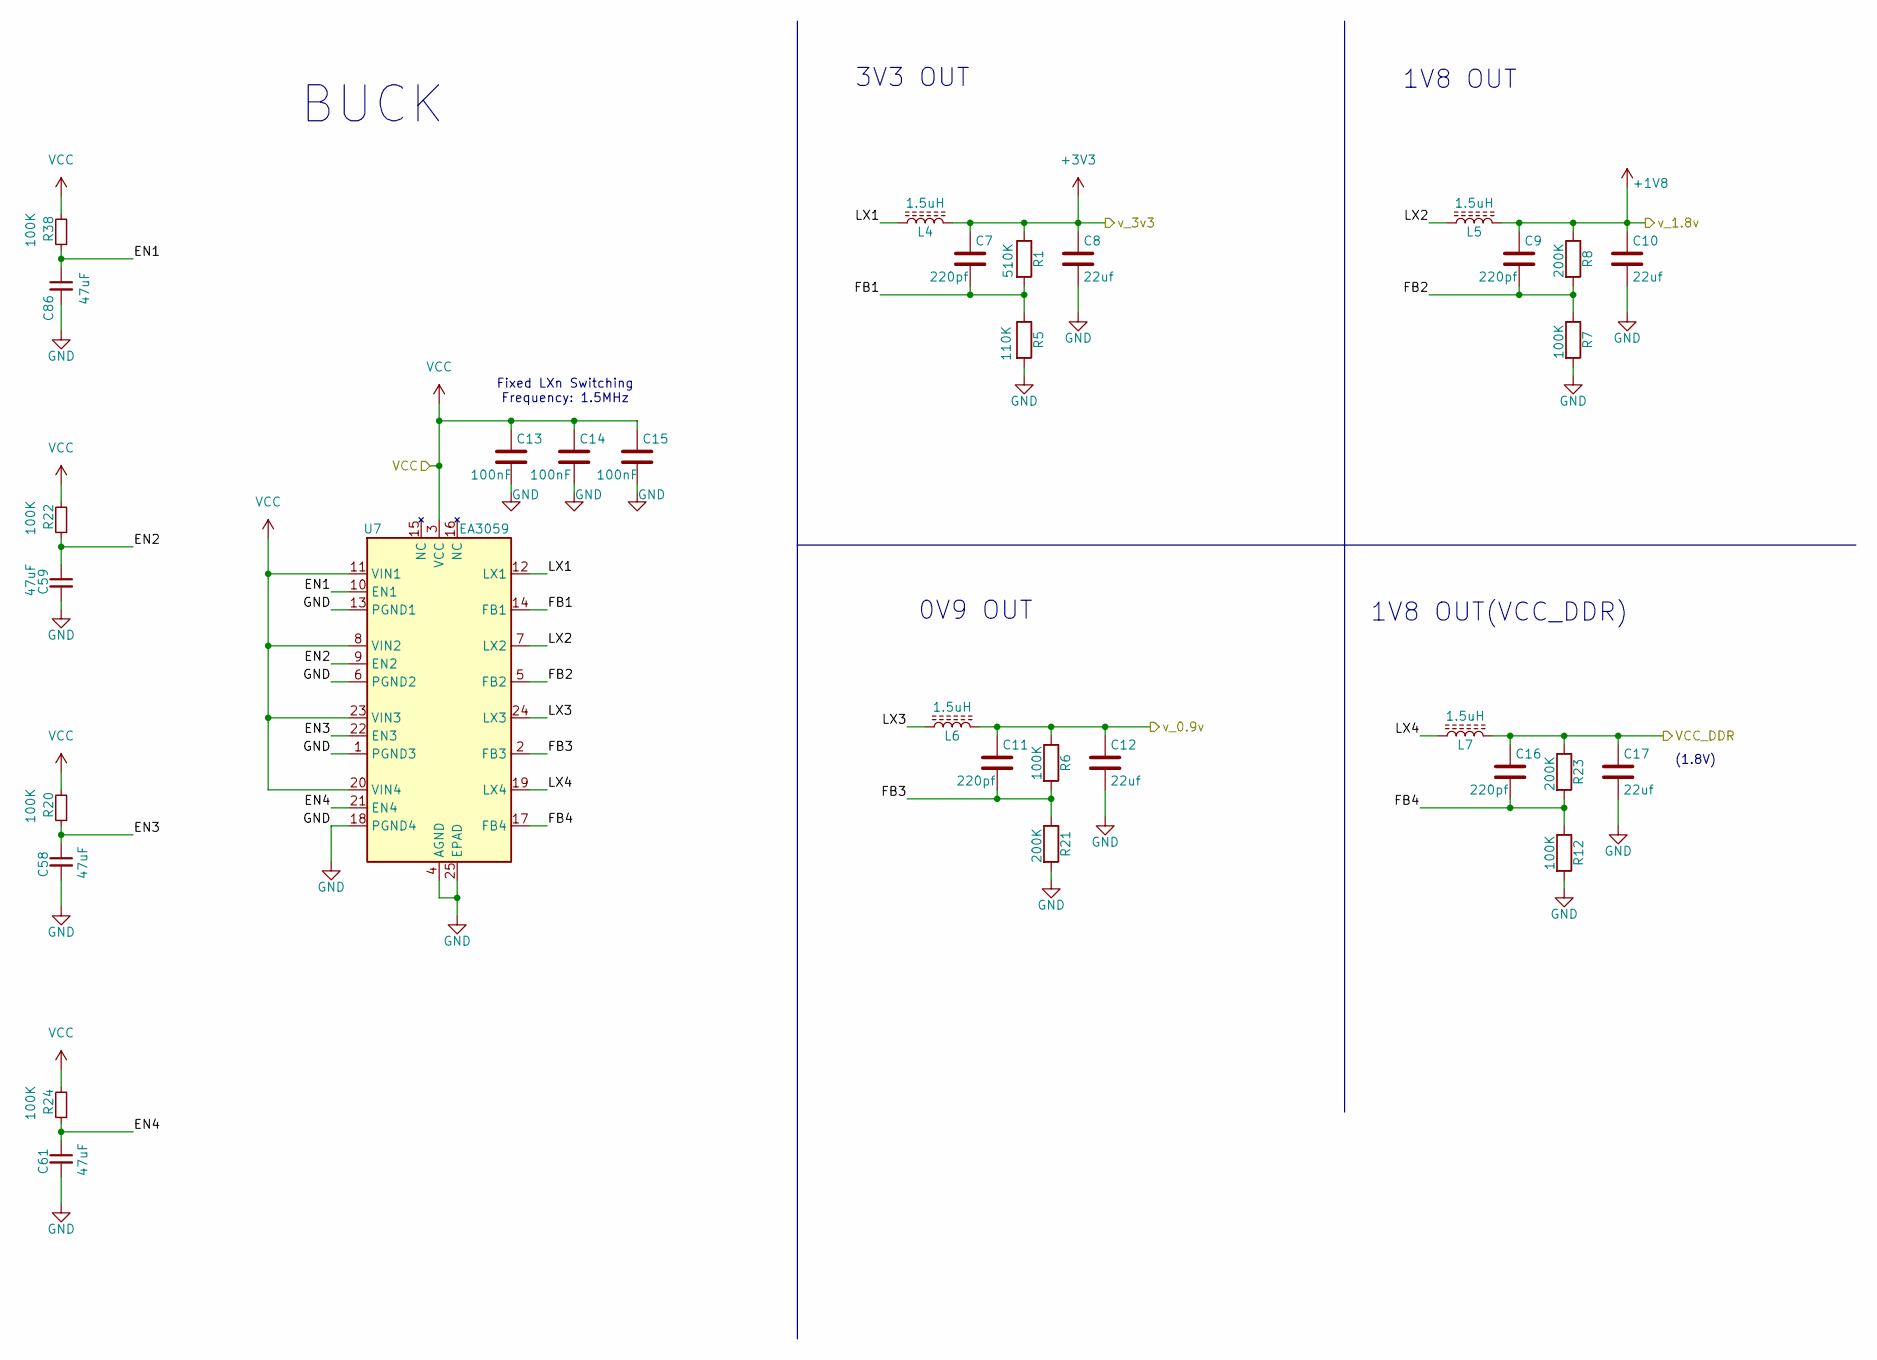
[picture p25: schematic Buck_Converter.kicad_sch, Badge-HackGDL-2026]

Parts:
C7, C9, C11, C16: 220pf; C_0402_1005Metric; LCSC# C107001
C8, C10, C12, C17: 22uf; C_0402_1005Metric; LCSC# C415703
C13, C14, C15: 100nF; C_0402_1005Metric; LCSC# C77020
C58, C59, C61, C86: 47uF; C_0603_1608Metric; LCSC# C140782
L4, L5, L6, L7: 1.5uH; L_1008_2520Metric; LCSC# C7427193
R1: 510K; R_0402_1005Metric; LCSC# C365024
R5: 110K; R_0402_1005Metric; LCSC# C2909311
R6, R7, R12, R20, R22, R24, R38: 100K; R_0402_1005Metric; LCSC# C844674
R8, R21, R23: 200K; R_0402_1005Metric; LCSC# C364966
U7: EA3059; VQFN-24-1EP_4x4mm_P0.5mm_EP2.5x2.5mm; LCSC# C111586

Connections:
+1V8: C9.1, C10.1, L5.2, R8.1; also elsewhere on the board
+3V3: C7.1, C8.1, L4.2, R1.1; also elsewhere on the board
/Buck_Converter/EN1: C86.1, R38.1, U7.10 (EN1)
/Buck_Converter/EN2: C59.1, R22.1, U7.9 (EN2)
/Buck_Converter/EN3: C58.1, R20.1, U7.22 (EN3)
/Buck_Converter/EN4: C61.1, R24.1, U7.21 (EN4)
/Buck_Converter/FB1: C7.2, R1.2, R5.1, U7.14 (FB1)
/Buck_Converter/FB2: C9.2, R7.1, R8.2, U7.5 (FB2)
/Buck_Converter/FB3: C11.2, R6.2, R21.1, U7.2 (FB3)
/Buck_Converter/FB4: C16.2, R12.1, R23.2, U7.17 (FB4)
/Buck_Converter/LX1: L4.1, U7.12 (LX1)
/Buck_Converter/LX2: L5.1, U7.7 (LX2)
/Buck_Converter/LX3: L6.1, U7.24 (LX3)
/Buck_Converter/LX4: L7.1, U7.19 (LX4)
/Buck_Converter/VCC_DDR: C16.1, C17.1, L7.2, R23.1; also elsewhere on the board
/MCU/VDD_ARM: C11.1, C12.1, L6.2, R6.1; also elsewhere on the board
GND: C8.2, C10.2, C12.2, C13.2, C14.2, C15.2, C17.2, C58.2, C59.2, C61.2, C86.2, R5.2, R7.2, R12.2, R21.2, U7.1 (PGND3), U7.4 (AGND), U7.6 (PGND2), U7.13 (PGND1), U7.18 (PGND4), U7.25 (EPAD); also elsewhere on the board
VCC: C13.1, C14.1, C15.1, R20.2, R22.2, R24.2, R38.2, U7.3 (VCC), U7.8 (VIN2), U7.11 (VIN1), U7.20 (VIN4), U7.23 (VIN3); also elsewhere on the board

Notes on the sheet:
Fixed LXn Switching Frequency: 1.5MHz
1V8 OUT(VCC_DDR)
1V8 OUT
(1.8V)
BUCK
0V9 OUT
3V3 OUT

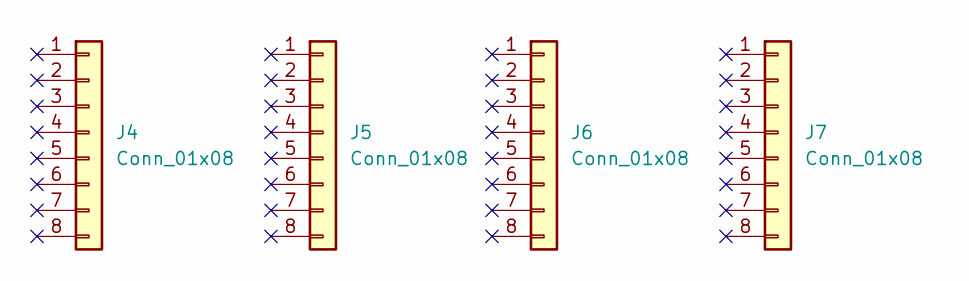
[picture p26: schematic Support pins.kicad_sch, Badge-HackGDL-2026]

Parts:
J4, J5, J6, J7: Conn_01x08; PinSocket_1x08_P2.54mm_Vertical; LCSC# C5224027

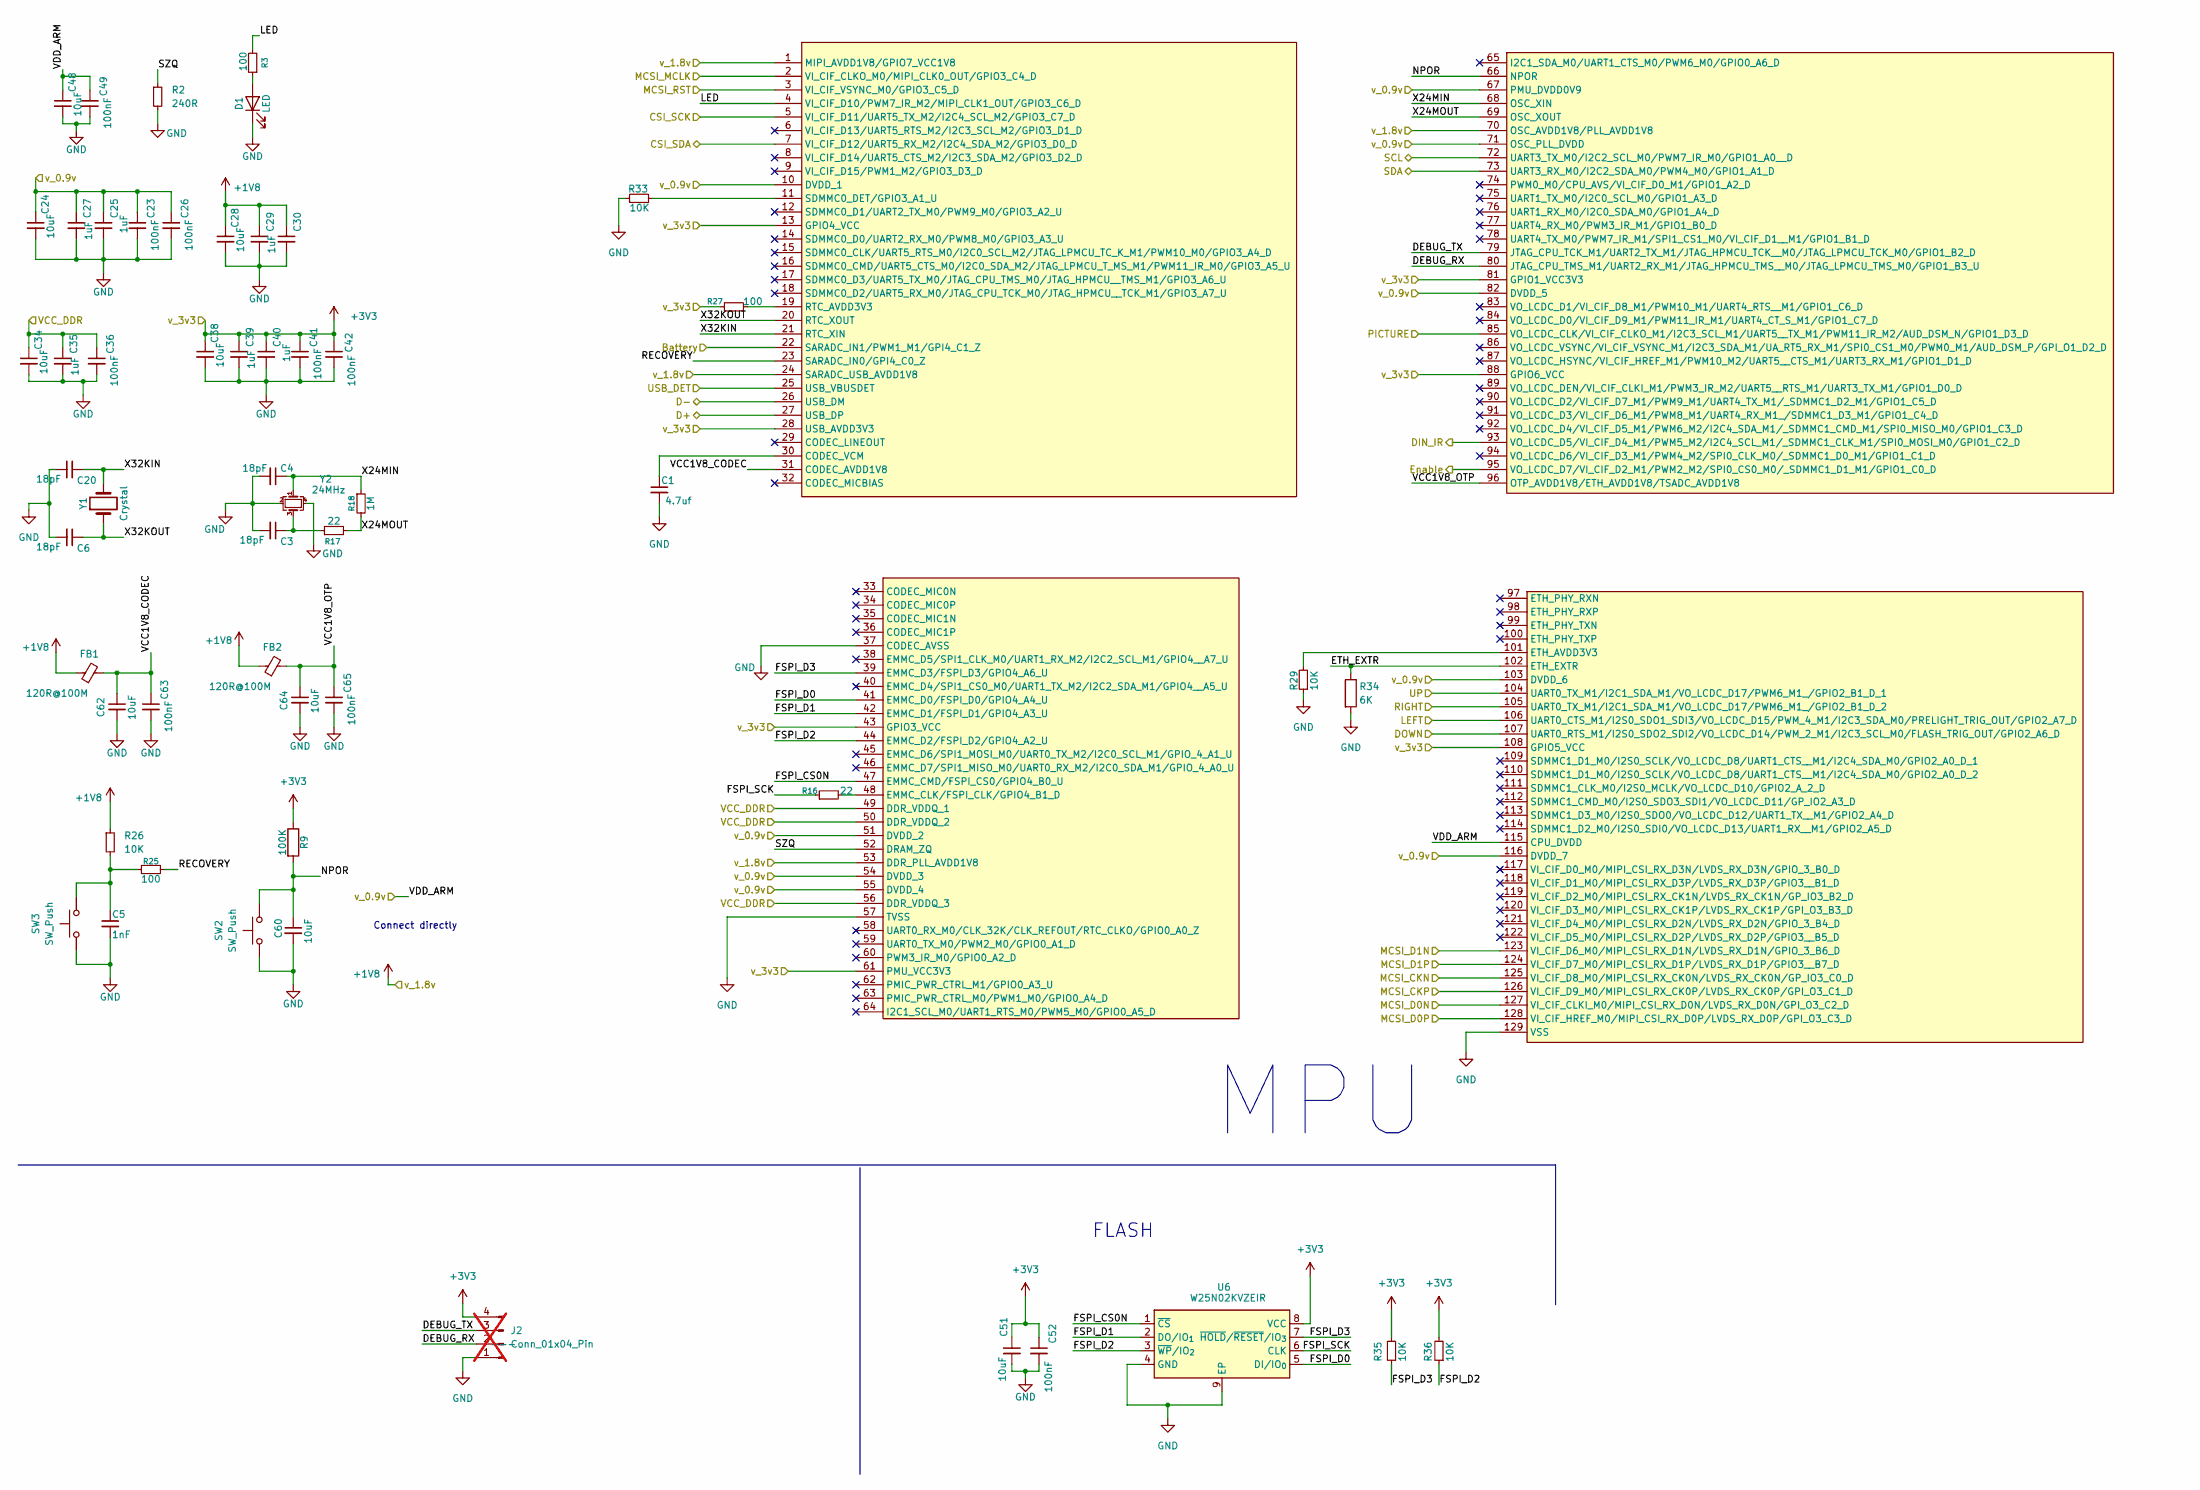
[picture p27: schematic MCU.kicad_sch, Badge-HackGDL-2026]

Parts:
C1: 4.7uf; C_0402_1005Metric; LCSC# C6119795
C3, C4, C6, C20: 18pF; C_0402_1005Metric; LCSC# C161534
C5: 1nF; C_0402_1005Metric; LCSC# C189467
C23, C26, C36, C41, C42, C49, C52, C63, C65: 100nF; C_0402_1005Metric; LCSC# C77020
C24, C28, C34, C38, C48, C51, C62, C64: 10uF; C_0402_1005Metric; LCSC# C7472949
C25, C27, C29, C30, C35, C39, C40: 1uF; C_0402_1005Metric; LCSC# C52923
C60: 10uF; C_0603_1608Metric; LCSC# C96446
D1: LED; LED_0603_1608Metric; LCSC# C22371297
FB1, FB2: 120R@100M; L_0603_1608Metric; LCSC# C14709
J2: Conn_01x04_Pin; 4 Pin 2.54mm; not fitted
R2: 240R; R_0402_1005Metric; LCSC# C25094
R3, R25, R27: 100; R_0402_1005Metric; LCSC# C2906860
R9: 100K; R_0402_1005Metric; LCSC# C844674
R16, R17: 22; R_0402_1005Metric; LCSC# C159964
R18: 1M; R_0402_1005Metric; LCSC# C131492
R26, R29, R33, R35, R36: 10K; R_0402_1005Metric; LCSC# C2759535
R34: 6K; R_0805_2012Metric; LCSC# C2828725
SW2, SW3: SW_Push; SW_SPST_TL3342; LCSC# C318889
U6: W25N02KVZEIR; WSON-8-1EP_8x6mm_P1.27mm_EP3.4x4.3mm; LCSC# C3010298
U8: RV1106G3; LCSC# C5328706
Y1: Crystal; Crystal_SMD_3215-2Pin_3.2x1.5mm; LCSC# C620155
Y2: 24MHz; Crystal_SMD_3225-4Pin_3.2x2.5mm; LCSC# C70590

Connections:
+1V8: C28.1, C29.1, C30.1, FB1.1, FB2.1, R26.1, U8.1 (MIPI_AVDD1V8/GPIO7_VCC1V8), U8.24 (SARADC_USB_AVDD1V8), U8.53 (DDR_PLL_AVDD1V8), U8.70 (OSC_AVDD1V8/PLL_AVDD1V8); also elsewhere on the board
+3V3: C38.1, C39.1, C40.1, C41.1, C42.1, C51.1, C52.1, J2.4, R9.1, R27.1, R35.2, R36.2, U6.8 (VCC), U8.13 (GPIO4_VCC), U8.28 (USB_AVDD3V3), U8.43 (GPIO3_VCC), U8.61 (PMU_VCC3V3), U8.81 (GPIO1_VCC3V3), U8.88 (GPIO6_VCC), U8.108 (GPIO5_VCC); also elsewhere on the board
/Buck_Converter/VCC_DDR: C34.1, C35.1, C36.1, U8.49 (DDR_VDDQ_1), U8.50 (DDR_VDDQ_2), U8.56 (DDR_VDDQ_3); also elsewhere on the board
/Cam/CSI_SCK: U8.5 (VI_CIF_D11/UART5_TX_M2/I2C4_SCL_M2/GPIO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); also elsewhere on the board
/Cam/CSI_SDA: U8.7 (VI_CIF_D12/UART5_RX_M2/I2C4_SDA_M2/GPIO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); also elsewhere on the board
/Cam/MCSI_CKN: U8.125 (VI_CIF_D8_M0/MIPI_CSI_RX_CK0N/LVDS_RX_C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); also elsewhere on the board
/Cam/MCSI_CKP: U8.126 (VI_CIF_D9_M0/MIPI_CSI_RX_CK0P/LVDS_RX_C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); also elsewhere on the board
/Cam/MCSI_D0N: U8.127 (VI_CIF_CLKI_M0/MIPI_CSI_RX_D0N/LVDS_RX_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); also elsewhere on the board
/Cam/MCSI_D0P: U8.128 (VI_CIF_HREF_M0/MIPI_CSI_RX_D0P/LVDS_RX_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); also elsewhere on the board
/Cam/MCSI_D1N: U8.123 (VI_CIF_D6_M0/MIPI_CSI_RX_D1N/LVDS_RX_D1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); also elsewhere on the board
/Cam/MCSI_D1P: U8.124 (VI_CIF_D7_M0/MIPI_CSI_RX_D1P/LVDS_RX_D1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); also elsewhere on the board
/Cam/MCSI_MCLK: U8.2 (VI_CIF_CLKO_M0/MIPI_CLK0_OUT/GPIO3_C4_D); also elsewhere on the board
/Cam/MCSI_RST: U8.3 (VI_CIF_VSYNC_M0/GPIO3_C5_D); also elsewhere on the board
/MCU/Battery: U8.22 (SARADC_IN1/PWM1_M1/GPI4_C1_Z); also elsewhere on the board
/MCU/D+: U8.27 (USB_DP); also elsewhere on the board
/MCU/D-: U8.26 (USB_DM); also elsewhere on the board
/MCU/DEBUG_RX: J2.2, U8.80 (JTAG_CPU_TMS_M1/UART2_RX_M1/JTAG_HPMCU_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)
/MCU/DEBUG_TX: J2.3, U8.79 (JTAG_CPU_TCK_M1/UART2_TX_M1/JTAG_HPMCU_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)
/MCU/DIN_IR: U8.93 (VO_LCDC_D5/VI_CIF_D4_M1/PWM5_M2/I2C4_SC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); also elsewhere on the board
/MCU/DOWN: U8.107 (UART0_RTS_M1/I2S0_SDO2_SDI2/VO_LCDC_D14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); also elsewhere on the board
/MCU/ETH_EXTR: R34.1, U8.102 (ETH_EXTR)
/MCU/Enable: U8.95 (VO_LCDC_D7/VI_CIF_D2_M1/PWM2_M2/SPI0_CS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); also elsewhere on the board
/MCU/FSPI_CS0N: U6.1 (~CS), U8.47 (EMMC_CMD/FSPI_CS0/GPIO4_B0_U)
/MCU/FSPI_D0: U6.5 (DI/IO_{0}), U8.41 (EMMC_D0/FSPI_D0/GPIO4_A4_U)
/MCU/FSPI_D1: U6.2 (DO/IO_{1}), U8.42 (EMMC_D1/FSPI_D1/GPIO4_A3_U)
/MCU/FSPI_D2: R36.1, U6.3 (~WP/IO_{2}), U8.44 (EMMC_D2/FSPI_D2/GPIO4_A2_U)
/MCU/FSPI_D3: R35.1, U6.7 (~HOLD/~RESET/IO_{3}), U8.39 (EMMC_D3/FSPI_D3/GPIO4_A6_U)
/MCU/FSPI_SCK: R16.1, U6.6 (CLK)
/MCU/LED: R3.2, U8.4 (VI_CIF_D10/PWM7_IR_M2/MIPI_CLK1_OUT/GPI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)
/MCU/LEFT: U8.106 (UART0_CTS_M1/I2S0_SDO1_SDI3/VO_LCDC_D15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); also elsewhere on the board
/MCU/NPOR: C60.1, R9.2, SW2.2, U8.66 (NPOR)
/MCU/PICTURE: U8.85 (VO_LCDC_CLK/VI_CIF_CLKO_M1/I2C3_SCL_M1/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); also elsewhere on the board
/MCU/RECOVERY: R25.2, U8.23 (SARADC_IN0/GPI4_C0_Z)
/MCU/RIGHT: U8.105 (UART0_TX_M1/I2C1_SDA_M1/VO_LCDC_D17/PWM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); also elsewhere on the board
/MCU/SCL: U8.72 (UART3_TX_M0/I2C2_SCL_M0/PWM7_IR_M0/GPIO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); also elsewhere on the board
/MCU/SDA: U8.73 (UART3_RX_M0/I2C2_SDA_M0/PWM4_M0/GPIO1_A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); also elsewhere on the board
/MCU/SZQ: R2.1, U8.52 (DRAM_ZQ)
/MCU/UP: U8.104 (UART0_TX_M1/I2C1_SDA_M1/VO_LCDC_D17/PWM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); also elsewhere on the board
/MCU/USB_DET: U8.25 (USB_VBUSDET); also elsewhere on the board
/MCU/VCC1V8_CODEC: C62.1, C63.1, FB1.2, U8.31 (CODEC_AVDD1V8)
/MCU/VCC1V8_OTP: C64.1, C65.1, FB2.2, U8.96 (OTP_AVDD1V8/ETH_AVDD1V8/TSADC_AVDD1V8)
/MCU/VDD_ARM: C23.1, C24.1, C25.1, C26.1, C27.1, C48.1, C49.1, U8.10 (DVDD_1), U8.51 (DVDD_2), U8.54 (DVDD_3), U8.55 (DVDD_4), U8.67 (PMU_DVDD0V9), U8.71 (OSC_PLL_DVDD), U8.82 (DVDD_5), U8.103 (DVDD_6), U8.115 (CPU_DVDD), U8.116 (DVDD_7); also elsewhere on the board
/MCU/X24MIN: C4.1, R18.1, U8.68 (OSC_XIN), Y2.1
/MCU/X24MOUT: R17.2, R18.2, U8.69 (OSC_XOUT)
/MCU/X32KIN: C20.1, U8.21 (RTC_XIN), Y1.2
/MCU/X32KOUT: C6.1, U8.20 (RTC_XOUT), Y1.1
GND: C1.2, C3.2, C4.2, C5.2, C6.2, C20.2, C23.2, C24.2, C25.2, C26.2, C27.2, C28.2, C29.2, C30.2, C34.2, C35.2, C36.2, C38.2, C39.2, C40.2, C41.2, C42.2, C48.2, C49.2, C51.2, C52.2, C60.2, C62.2, C63.2, C64.2, C65.2, D1.1 (K), J2.1, R2.2, R29.1, R33.1, R34.2, SW2.1, SW3.1, U6.4 (GND), U6.9 (EP), U8.37 (CODEC_AVSS), U8.57 (TVSS), U8.129 (VSS), Y2.2, Y2.4; also elsewhere on the board
unnamed: C3.1, R17.1, Y2.3
unnamed: C5.1, R25.1, R26.2, SW3.2
unnamed: D1.2 (A), R3.1
unnamed: C1.1, U8.30 (CODEC_VCM)
unnamed: R27.2, U8.19 (RTC_AVDD3V3)
unnamed: R33.2, U8.11 (SDMMC0_DET/GPIO3_A1_U)
unnamed: R16.2, U8.48 (EMMC_CLK/FSPI_CLK/GPIO4_B1_D)
unnamed: R29.2, U8.101 (ETH_AVDD3V3)

Notes on the sheet:
FLASH
Connect directly
MPU

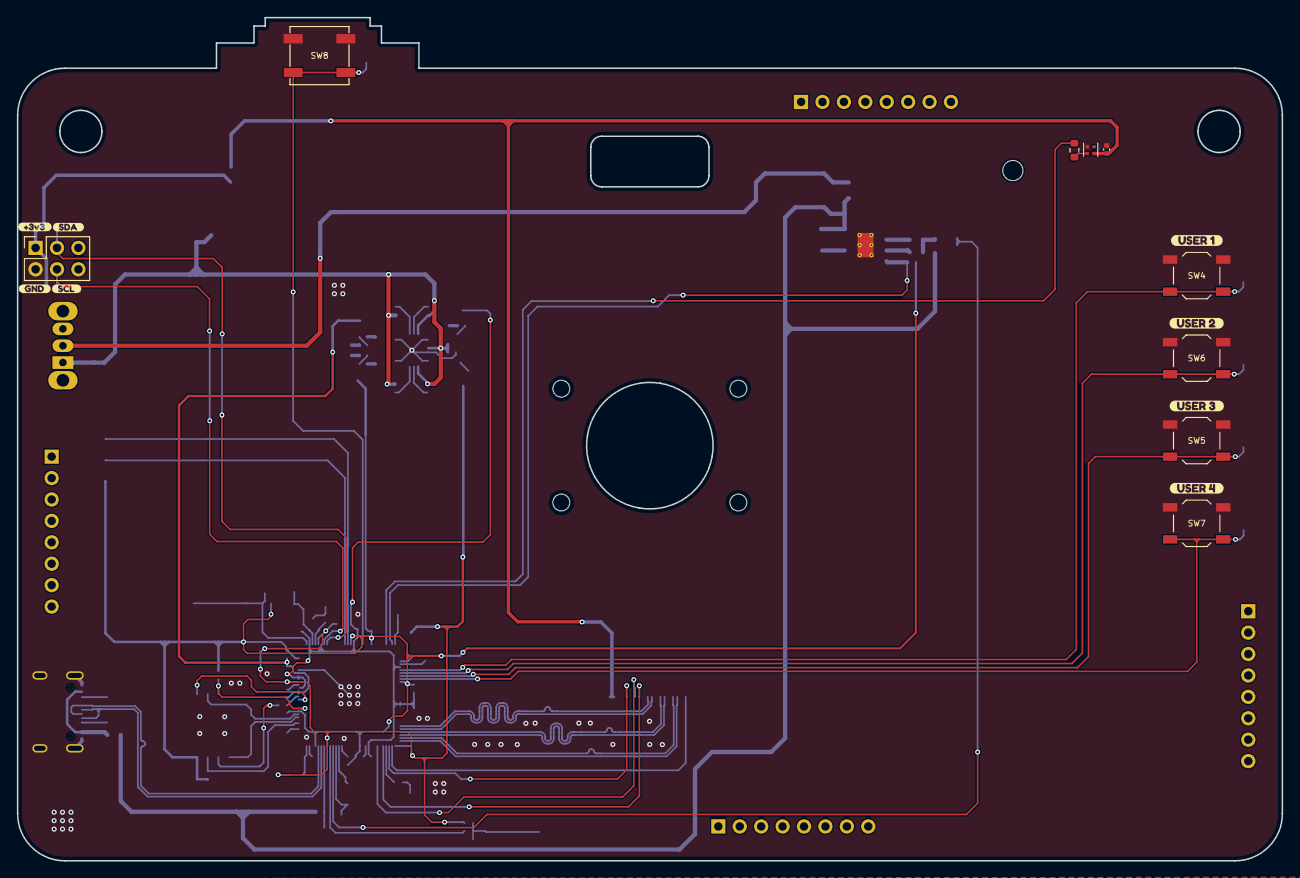
[picture p28: board Badge-HackGDL-2026.kicad_pcb from above]

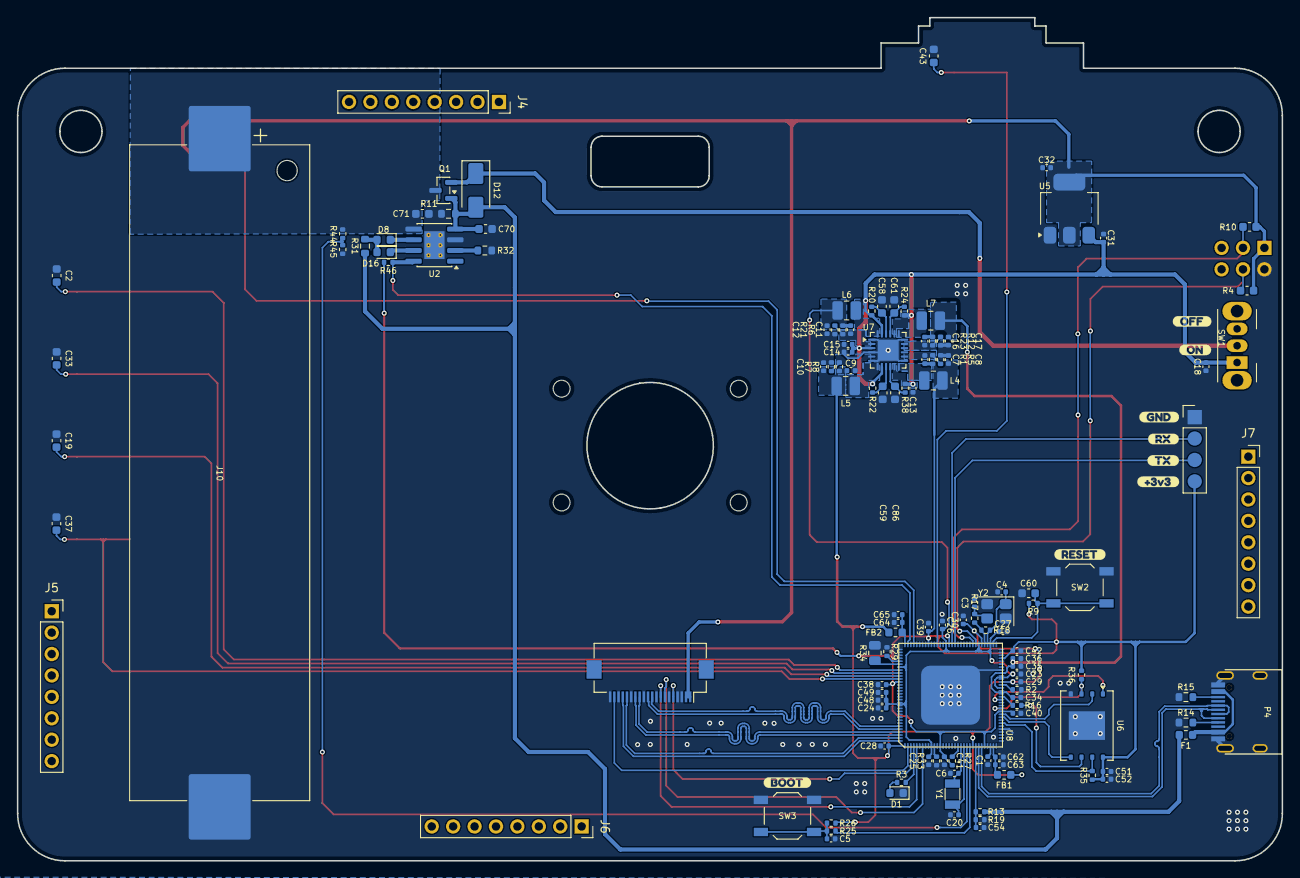
[picture p29: board Badge-HackGDL-2026.kicad_pcb from below]

Board: 2 copper layers, 150.0 x 100.0 mm, 151 parts (133 on the bottom side), 80 nets.

Other parts of the board:
kibuzzard-684B03BD: G***; kibuzzard-684B03BD
kibuzzard-684B03C9: G***; kibuzzard-684B03C9
kibuzzard-684B03D5: G***; kibuzzard-684B03D5
kibuzzard-69714B9C: G***; kibuzzard-69714B9C
kibuzzard-69714BBC: G***; kibuzzard-69714BBC
kibuzzard-69714BDE: G***; kibuzzard-69714BDE
kibuzzard-69714C02: G***; kibuzzard-69714C02
kibuzzard-69714C5E: G***; kibuzzard-69714C5E
kibuzzard-69714C72: G***; kibuzzard-69714C72
kibuzzard-69714C98: G***; kibuzzard-69714C98
kibuzzard-69714CA0: G***; kibuzzard-69714CA0
kibuzzard-6892465C: G***; kibuzzard-6892465C
kibuzzard-6971487E: G***; kibuzzard-6971487E
kibuzzard-6971488E: G***; kibuzzard-6971488E
kibuzzard-69714845: G***; kibuzzard-69714845
kibuzzard-69714866: G***; kibuzzard-69714866
