ElectronicCats/badge_hackgdl_2026/Add-ons/Firmware/Add-on-Pescadito-HackGDL-Firmware/User/main.c

/**
 ******************************************************************************
 * @file    main.c
 * @author  MCU Application Team
 * @brief   Main program body
 ******************************************************************************
 * @attention
 *
 * <h2><center>&copy; Copyright (c) Puya Semiconductor Co.
 * All rights reserved.</center></h2>
 *
 * <h2><center>&copy; Copyright (c) 2016 STMicroelectronics.
 * All rights reserved.</center></h2>
 *
 * This software component is licensed by ST under BSD 3-Clause license,
 * the "License"; You may not use this file except in compliance with the
 * License. You may obtain a copy of the License at:
 *                        opensource.org/licenses/BSD-3-Clause
 *
 * J-Link Connections: https://private-user-images.githubusercontent.com/44976441/277049150-2c44cddc-163c-4924-840f-2b99760bbca3.png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
 * PUYA instructions: https://github.com/ElectronicCats/puya-projects
 *
 ******************************************************************************
 */

/* Includes ------------------------------------------------------------------*/
#include "py32f0xx_bsp_printf.h"
#include <stdint.h>

/* Private define ------------------------------------------------------------*/
/* Private variables ---------------------------------------------------------*/
/* Private user code ---------------------------------------------------------*/
/* Private macro -------------------------------------------------------------*/
/* Private function prototypes -----------------------------------------------*/
static void APP_LedConfig(void);
uint16_t delay1 = 2000, delay3 = 4000;
uint8_t delay = 200, delay2 = 250, delay4 = 50;


// Sequence 1
void eyeSequence()
{
  HAL_GPIO_OnPin(GPIOA, GPIO_PIN_5);
  HAL_Delay(delay1);
  HAL_GPIO_OffPin(GPIOA, GPIO_PIN_5);
  HAL_Delay(delay);

  //Bink
  HAL_GPIO_OnPin(GPIOA, GPIO_PIN_5);
  HAL_Delay(delay);
  HAL_GPIO_OffPin(GPIOA, GPIO_PIN_5);
  HAL_Delay(delay);
  HAL_GPIO_OnPin(GPIOA, GPIO_PIN_5);
  HAL_Delay(delay);
  HAL_GPIO_OffPin(GPIOA, GPIO_PIN_5);
  HAL_Delay(delay);
  HAL_GPIO_OnPin(GPIOA, GPIO_PIN_5);
  HAL_Delay(delay);
  HAL_GPIO_OffPin(GPIOA, GPIO_PIN_5);
  HAL_Delay(delay);
}

// Sequence 2
void finsSequence()
{
  HAL_GPIO_OnPin(GPIOA, GPIO_PIN_5);
  HAL_GPIO_OnPin(GPIOF, GPIO_PIN_0); 
  HAL_Delay(delay2);
  HAL_GPIO_OnPin(GPIOA, GPIO_PIN_1);
  HAL_Delay(delay2);
  HAL_GPIO_OnPin(GPIOA, GPIO_PIN_7);
  HAL_Delay(delay2);
  HAL_GPIO_OnPin(GPIOA, GPIO_PIN_6);
  HAL_Delay(delay1);
  HAL_GPIO_OffPin(GPIOF, GPIO_PIN_0);
  HAL_Delay(delay2);
  HAL_GPIO_OffPin(GPIOA, GPIO_PIN_1);
  HAL_Delay(delay2);
  HAL_GPIO_OffPin(GPIOA, GPIO_PIN_7);
  HAL_Delay(delay2);
  HAL_GPIO_OffPin(GPIOA, GPIO_PIN_6);
  HAL_Delay(delay);
  HAL_GPIO_OnPin(GPIOF, GPIO_PIN_0); 
  HAL_GPIO_OnPin(GPIOA, GPIO_PIN_1);
  HAL_GPIO_OnPin(GPIOA, GPIO_PIN_6);
  HAL_GPIO_OnPin(GPIOA, GPIO_PIN_7);
  HAL_Delay(delay);
  HAL_GPIO_OffPin(GPIOF, GPIO_PIN_0); 
  HAL_GPIO_OffPin(GPIOA, GPIO_PIN_1);
  HAL_GPIO_OffPin(GPIOA, GPIO_PIN_6);
  HAL_GPIO_OffPin(GPIOA, GPIO_PIN_7);
  HAL_Delay(delay);
  HAL_GPIO_OnPin(GPIOF, GPIO_PIN_0); 
  HAL_GPIO_OnPin(GPIOA, GPIO_PIN_1);
  HAL_GPIO_OnPin(GPIOA, GPIO_PIN_6);
  HAL_GPIO_OnPin(GPIOA, GPIO_PIN_7);
  HAL_Delay(delay);
  HAL_GPIO_OffPin(GPIOF, GPIO_PIN_0); 
  HAL_GPIO_OffPin(GPIOA, GPIO_PIN_1);
  HAL_GPIO_OffPin(GPIOA, GPIO_PIN_6);
  HAL_GPIO_OffPin(GPIOA, GPIO_PIN_7);
  HAL_Delay(delay);
  HAL_GPIO_OnPin(GPIOF, GPIO_PIN_0); 
  HAL_GPIO_OnPin(GPIOA, GPIO_PIN_1);
  HAL_GPIO_OnPin(GPIOA, GPIO_PIN_6);
  HAL_GPIO_OnPin(GPIOA, GPIO_PIN_7);
  HAL_Delay(delay);
  HAL_GPIO_OffPin(GPIOA, GPIO_PIN_1);
  HAL_GPIO_OffPin(GPIOA, GPIO_PIN_6);
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
  HAL_GPIO_OffPin(GPIOA, GPIO_PIN_7);
  HAL_Delay(delay4);
  HAL_GPIO_OnPin(GPIOA, GPIO_PIN_6); 
  HAL_Delay(delay4);
  HAL_GPIO_OffPin(GPIOA, GPIO_PIN_6);
  HAL_Delay(delay4);
  HAL_GPIO_OnPin(GPIOA, GPIO_PIN_1); 
  HAL_Delay(delay4);
  HAL_GPIO_OffPin(GPIOA, GPIO_PIN_1);
  HAL_Delay(delay4);

  HAL_GPIO_OnPin(GPIOA, GPIO_PIN_5);
  HAL_Delay(delay4);
  HAL_GPIO_OffPin(GPIOA, GPIO_PIN_5);
  HAL_Delay(delay4);
  HAL_GPIO_OnPin(GPIOF, GPIO_PIN_0); 
  HAL_Delay(delay4);
  HAL_GPIO_OffPin(GPIOF, GPIO_PIN_0);
  HAL_Delay(delay4);
  HAL_GPIO_OnPin(GPIOA, GPIO_PIN_7); 
  HAL_Delay(delay4);
  HAL_GPIO_OffPin(GPIOA, GPIO_PIN_7);
  HAL_Delay(delay4);
  HAL_GPIO_OnPin(GPIOA, GPIO_PIN_6); 
  HAL_Delay(delay4);
  HAL_GPIO_OffPin(GPIOA, GPIO_PIN_6);
  HAL_Delay(delay4);
  HAL_GPIO_OnPin(GPIOA, GPIO_PIN_1); 
  HAL_Delay(delay4);
  HAL_GPIO_OffPin(GPIOA, GPIO_PIN_1);
  HAL_Delay(delay4);

  HAL_GPIO_OnPin(GPIOA, GPIO_PIN_5);
  HAL_Delay(delay4);
  HAL_GPIO_OffPin(GPIOA, GPIO_PIN_5);
  HAL_Delay(delay4);
  HAL_GPIO_OnPin(GPIOF, GPIO_PIN_0); 
  HAL_Delay(delay4);
  HAL_GPIO_OffPin(GPIOF, GPIO_PIN_0);
  HAL_Delay(delay4);
  HAL_GPIO_OnPin(GPIOA, GPIO_PIN_7); 
  HAL_Delay(delay4);
  HAL_GPIO_OffPin(GPIOA, GPIO_PIN_7);
  HAL_Delay(delay4);
  HAL_GPIO_OnPin(GPIOA, GPIO_PIN_6); 
  HAL_Delay(delay4);
  HAL_GPIO_OffPin(GPIOA, GPIO_PIN_6);
  HAL_Delay(delay4);
  HAL_GPIO_OnPin(GPIOA, GPIO_PIN_1); 
  HAL_Delay(delay4);
  HAL_GPIO_OffPin(GPIOA, GPIO_PIN_1);
  HAL_Delay(delay4);
}

void sequences(int sequence)
{
  switch (sequence)
  {
  case 1:
    eyeSequence();
    break;
  case 2:
    finsSequence();
    break;
  case 3:
    rouletteSequence();
    break;
  case 4:
    allSequence();
    break;
  case 5:
    slowrouletteSequence();
    break;
  case 6:
    allblinkSequence();
    break;
    case 7:
    fastrouletteSequence();
    break;
  default:
    ledsOn();
    HAL_Delay(1000);
    break;
  }
}

int main(void)
{
  HAL_Init();

  APP_LedConfig();

  BSP_USART_Config();
  
  while (1)
  {
    for (uint8_t c = 1; c < 8; c++)
    {
      sequences(c);
    }
  }
}

static void APP_LedConfig(void)
{
  GPIO_InitTypeDef GPIO_InitStruct;

  __HAL_RCC_GPIOA_CLK_ENABLE();

  GPIO_InitStruct.Pin = GPIO_PIN_1;
  GPIO_InitStruct.Mode = GPIO_MODE_OUTPUT_PP;
  GPIO_InitStruct.Pull = GPIO_PULLUP;
  GPIO_InitStruct.Speed = GPIO_SPEED_FREQ_HIGH;
  HAL_GPIO_Init(GPIOA, &GPIO_InitStruct);

  __HAL_RCC_GPIOA_CLK_ENABLE();

  GPIO_InitStruct.Pin = GPIO_PIN_6;
  GPIO_InitStruct.Mode = GPIO_MODE_OUTPUT_PP;
  GPIO_InitStruct.Pull = GPIO_PULLUP;
  GPIO_InitStruct.Speed = GPIO_SPEED_FREQ_HIGH;
  HAL_GPIO_Init(GPIOA, &GPIO_InitStruct);

  __HAL_RCC_GPIOA_CLK_ENABLE();

  GPIO_InitStruct.Pin = GPIO_PIN_7;
  GPIO_InitStruct.Mode = GPIO_MODE_OUTPUT_PP;
  GPIO_InitStruct.Pull = GPIO_PULLUP;
  GPIO_InitStruct.Speed = GPIO_SPEED_FREQ_HIGH;

  HAL_GPIO_Init(GPIOA, &GPIO_InitStruct);

  __HAL_RCC_GPIOA_CLK_ENABLE();

  GPIO_InitStruct.Pin = GPIO_PIN_5;
  GPIO_InitStruct.Mode = GPIO_MODE_OUTPUT_PP;
  GPIO_InitStruct.Pull = GPIO_PULLUP;
  GPIO_InitStruct.Speed = GPIO_SPEED_FREQ_HIGH;

  HAL_GPIO_Init(GPIOA, &GPIO_InitStruct);

  __HAL_RCC_GPIOF_CLK_ENABLE();

  GPIO_InitStruct.Pin = GPIO_PIN_0;
  GPIO_InitStruct.Mode = GPIO_MODE_OUTPUT_PP;
  GPIO_InitStruct.Pull = GPIO_PULLUP;
  GPIO_InitStruct.Speed = GPIO_SPEED_FREQ_HIGH;

  HAL_GPIO_Init(GPIOF, &GPIO_InitStruct);
}

void APP_ErrorHandler(void)
{
  while (1)
    ;
}

#ifdef USE_FULL_ASSERT

void assert_failed(uint8_t *file, uint32_t line)
{
  while (1)
  {
  }
}
#endif /* USE_FULL_ASSERT */

/************************ (C) COPYRIGHT Puya *****END OF FILE******************/
