ElectronicCats/badge_hackgdl_2026/(commit log)

2026-02-19 feat: add submodule luckfox-pico
2026-03-04 feat: update submodule luckfox-pico
2026-04-30 feat: Update submodule luckfox-pico sdk
2026-05-19 Adds startup and capture LED indicators
    Implements visual feedback using the NeoPixel for key system events.
    A green blink sequence confirms successful device startup, providing a clear initialization signal.
    A white blink sequence is triggered when the capture button (`KEY_ENTER`) is pressed, signaling that a photo has been taken. This uses an atomic flag (`sig_atomic_t`) for safe inter-thread communication, ensuring responsiveness without disrupting ongoing animations.
2026-10-23 docs: update badge guide for v2.0.0 firmware
    Actualiza el README principal al firmware v2.0.0:
    - captura con badge_photo, overlay.ini y editor web;
    - MTP/ADB/RNDIS, rutinas RGB y botones;
    - build con la capa badge/ de la rama v2.0.0;
    - captura del editor y limpieza de imagenes MTP obsoletas.
2026-10-23 chore: point luckfox-pico submodule to v2.0.0
    Actualiza el submodulo a la rama badge_hackgdl_2026_v2.0.0
    (9e63a32d1) y deja .gitmodules siguiendo esa rama.
2026-10-24 fix: document USB reconnect and update firmware submodule
    Actualiza el submodulo a 949a68c82 (watchdog de reconexion USB),
    actualiza el SHA256 de la imagen y documenta que la badge reenumera al
    reconectar el cable sin cortar la alimentacion.
2026-10-24 chore: rename firmware branch to badge_hackgdl_2026_v2
    Actualiza .gitmodules y los enlaces del README a la rama
    badge_hackgdl_2026_v2. El submodulo queda en 949a68c82.
